murilo999-666/foguetes-garrafa-pet/foguetes/bit03/otimizacao/plots/run_1/surface_ballast_fill_fin_thickness.png

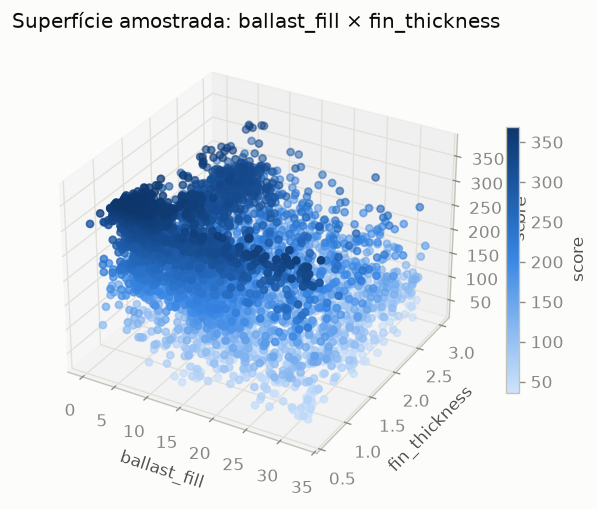
foguetes/bit03/otimizacao/plots/run_1/surface_ballast_fill_fin_thickness.png
