murilo999-666/foguetes-garrafa-pet/laboratorios/construivel/simulacoes/plots/run_1/heatmap_body_length_vinegar_fill.png

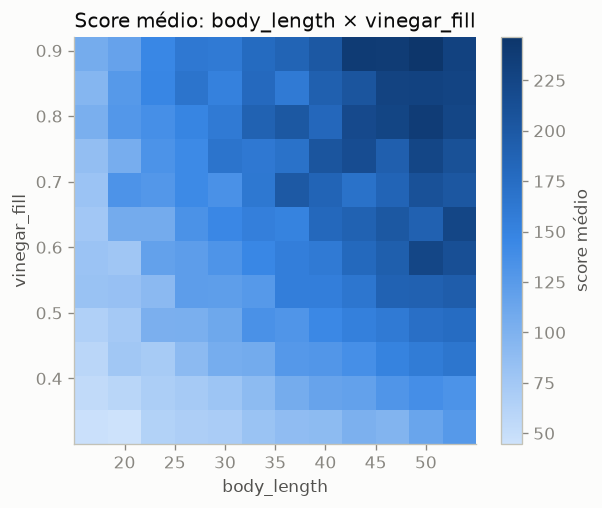
laboratorios/construivel/simulacoes/plots/run_1/heatmap_body_length_vinegar_fill.png
