murilo999-666/foguetes-garrafa-pet/foguetes/bit08/LEIA-ME.md

# bit08 — aletas a 45 graus (6 aletas)

**Projeto vigente: `bit08_MODELO_FINAL.ork`**

## Conteúdo

- `bit08_MODELO_FINAL.ork` — o projeto
- `MOLDE_ALETA_bit08.pdf` — molde de corte da aleta, imprimir em escala 1:1
- `GABARITO_6_ALETAS.pdf` — gabarito de alinhamento das 6 aletas no corpo
- `aletas.svg` — o desenho vetorial da aleta
- `coifa_INTEIRA_parede1.2mm.stl` — coifa em peça única
- `coifa_PARTIDA_1_base.stl` / `coifa_PARTIDA_2_ponta.stl` — a mesma coifa
  dividida em duas, para quem tem mesa de impressão pequena

Antes de imprimir o molde, confira que a impressora não está reescalando a
página (imprimir em "tamanho real", não em "ajustar à página"), senão a aleta
sai com a corda errada e o `.ork` deixa de valer.
