murilo999-666/foguetes-garrafa-pet/foguetes/bit09/LEIA-ME.md

# bit09 — otimizada (3 aletas)

**Projeto vigente: `bit09_MODELO_FINAL.ork`**

## Conteúdo

- `bit09_MODELO_FINAL.ork` — o projeto
- `MOLDE_ALETA_bit09.pdf` — molde de corte da aleta, imprimir em escala 1:1
- `GABARITO_3_ALETAS.pdf` — gabarito de alinhamento das 3 aletas no corpo
- `coifa_INTEIRA_parede1.2mm.stl` — coifa em peça única
- `coifa_PARTIDA_1_base.stl` / `coifa_PARTIDA_2_ponta.stl` — a mesma coifa
  dividida em duas, para mesa de impressão pequena
- `submodelo_coifa_antiga/` — três `.ork` do mesmo foguete com a coifa antiga
  (mínimo, central e máximo). Servem para comparar o efeito da coifa nova;
  não são o projeto vigente. Ver o `LEIA-ME.txt` de dentro.

Antes de imprimir o molde, confira que a impressora não está reescalando a
página (imprimir em "tamanho real", não em "ajustar à página").
