murilo999-666/foguetes-garrafa-pet/foguetes/bit04-2L/LEIA-ME.md

# bit04 — foguete otimizado (garrafa PET 2L)

**Projeto vigente: `bit04_MODELO_FINAL.ork`**

Materiais reais: ogiva impressa em PLA (parede 1,12 mm), aletas de poliestireno
1,0 mm, lastro de 426 g de Durepoxi na ponta da ogiva. Lançamento a 52°.

| Motor | Alcance (média de 20 ventos) | Estabilidade pós-queima |
|---|---|---|
| VinagreReal-1_55L (170 psi, validado) | 369,2 m | 1,01 cal |
| VinagreReal-1_8L (196 psi) | 388,1 m | 1,02 cal |

ATENÇÃO na impressão: a parede da ogiva de 1,12 mm precisa de pelo menos 3
perímetros. Se sair mais fina, o foguete perde lastro e fica instável.
Confirme os 426 g de Durepoxi na balança.

## Outros arquivos
- `bit04.ork`, `bit04_otimizado.ork` — versões anteriores deste foguete
- `foguete_real/` — o estudo digital completo da garrafa 2L (calibração dos
  motores, modelo humano, testes com lastro metálico, bancos de simulação)
- `motores/` — família .eng calibrada
- `backups/` — cópias antigas
