murilo999-666/foguetes-garrafa-pet/foguetes/bit05-2L/LEIA-ME.md

# bit05 — foguete projetado por conhecimento humano (garrafa PET 2L)

**Projeto vigente: `bit05_MODELO_FINAL.ork`**

Projetado 100% por pesquisa e física (OBAFOG, Apogee, Nakka, CFD subsônico),
SEM otimizador — para comparar com o bit04, que saiu de 300 mil simulações.
As fontes e o raciocínio estão em `MODELO_HUMANO_pesquisa.md`.

Materiais reais: ogiva ogival de 22 cm impressa em PLA (parede 1,2 mm), 3 aletas
enflechadas de poliestireno 1,0 mm, 115 g de Durepoxi. Lançamento a 46°.

Alcance previsto: **276 m** com o motor VinagreReal-1_55L (170 psi) —
praticamente igual aos 275 m que o bit03 fez de verdade no campo.

Filosofia: leve, aletas grandes, só o lastro necessário. O bit04 (otimizado) faz
o oposto — pesado, aletas pequenas — e chega a 369 m.
