murilo999-666/foguetes-garrafa-pet/foguetes/bit06-1.8L/_MODELO_ANTIGO_falhou/LEIA-ME.md

# bit06 — garrafa PET retornável REDUZIDA (~1,8 L, Ø9,585 cm)

**Projeto vigente: `bit06_MODELO_FINAL.ork`** (= o campeão com pressão validada
de 170 psi; cópia de `foguete_bit06_OTIMIZADO_SEGURO_170psi.ork`)

Garrafa reduzida de 2L para ~1,8 L: Ø9,585 cm, 33 cm, ~104 g (mesmo peso de uma
retornável comum). Volume menor = mais pressão para a mesma carga de vinagre, e
raio menor = aguenta mais pressão.

| Versão | Motor | Alcance (20 ventos) | Estabilidade |
|---|---|---|---|
| `bit06_MODELO_FINAL.ork` (recomendado) | 1,35 L / **170 psi** | **363,3 m** | 1,03 cal |
| `foguete_bit06_OTIMIZADO.ork` | 1,5 L / 189 psi | 376,2 m | 1,05 cal |
| `foguete_bit06_MODELO_HUMANO.ork` | 1,35 L / 170 psi | 279 m | 1,03 cal |

`garrafa_bit06_base.ork` = o modelo fiel da garrafa vazia (base para novos projetos).
Motores em `motores/` (VinagreBit06-*.eng, 0,5 a 1,5 L de vinagre).
