murilo999-666/foguetes-garrafa-pet/foguetes/bit06-1.8L/_MODELO_ANTIGO_falhou/motores/info_motores.txt

Motores da garrafa reduzida bit05 (~1,8 L internos).
Quimica calibrada em 170 psi/1,55 L (2L); fator de voo k=2.172 (275 m reais).
Volume menor -> mesma carga gera mais pressao que na 2L.
Raio menor (4,79 cm) -> aguenta mais pressao para a mesma parede.
