murilo999-666/foguetes-garrafa-pet/foguetes/bit08/GABARITO_6_ALETAS.pdf

## Gabarito de alinhamento - 6 aletas

Para o bit08. Voce so tem gabarito de 3 - este e o de 6.
Garrafa PET 2L retornavel: diametro 104.0 mm, circunferencia 326.7 mm.

COMO USAR
1. Confira a regua: a barra tem de medir 100 mm de verdade.
2. Recorte a cinta pela linha externa, incluindo a aba de emenda.
3. Enrole na garrafa com a borda de baixo encostada num apoio plano,
para a cinta ficar perpendicular ao eixo.
4. Faca a ponta ESQUERDA coincidir com a linha 'EMENDA AQUI' da direita.
5. Marque a garrafa em cada traco. Sao 6 marcas a 60.0 graus.
6. Alinhe o BORDO DE ATAQUE da raiz de cada aleta na marca.

esta barra tem de medir 100 mm

ALETA 1 | ALETA 2 | ALETA 3 | ALETA 4

tira 1 - de 0.0 a 190.0 mm da circunferencia

ALETA 5 | ALETA 6

EMENDA AQUI

tira 2 - de 190.0 a 326.7 mm da circunferencia
