murilo999-666/foguetes-garrafa-pet/foguetes/bit08/MOLDE_ALETA_bit08.pdf

## bit08 - trapezio da foto (BA 45 graus, BF perpendicular)

Foguete bit08 - OBAFOG modelo 4 - garrafa PET 2L retornavel
6 aletas iguais. Imprimir em ESCALA REAL (100%), sem 'ajustar a pagina'.
A linha tracejada horizontal e a linha do corpo reto da garrafa; a parte
abaixo dela e o lobo que acompanha a curva do ombro.
- Corda da raiz (sobre a linha do corpo reto): 90.0 mm
- Corda da ponta: 34.3 mm Envergadura: 55.7 mm Enflechamento: 55.7 mm
- Bordo de ataque: 45.0 graus
- Area de cada aleta (com o lobo do ombro): 39.6 cm2
- Linha de cola (segue o ombro): 99 mm
- Quantidade a cortar: 6 aletas iguais
- Construcao: depron 2mm + PET de garrafa 0,3mm 2 lados
- As pontas ocupam 215 mm de diametro - confira a base antes de cortar.
- Lastro: 368 g de chumbinho de pesca socado na PONTA da coifa.
- Posicionar: o bordo de ataque da raiz fica a 176 mm do topo do
- cilindro da garrafa (a marca tracejada indica onde o cilindro acaba).
- Margem de estabilidade: 2.00 cal no fim do voo, minima de 0.00 cal.
- As peles saem do cilindro de uma garrafa 2L cortada e achatada.
- Lixe o PET antes de colar - epoxi nao pega em PET liso.
- Cole as duas faces no mesmo dia, prensado ate curar.
- OPCIONAL, e o melhor uso do seu rolo: uma tira de carbono de 100 mm ao
- longo da LINHA DE COLA, nas duas faces de cada aleta. A tira de 10 cm
- nao serve de pele inteira, mas serve exatamente para isto - reforcar a
- juncao, que e onde a aleta arranca. Gasta ~900 mm do rolo nas 3 aletas.

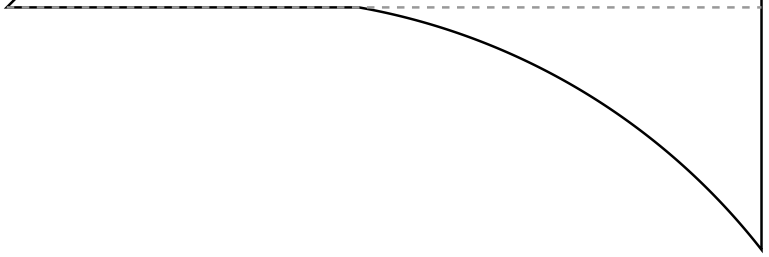
[picture p5: figure]

vista reduzida - o molde 1:1 vem nas 1 folhas seguintes (1 col x 1 lin)

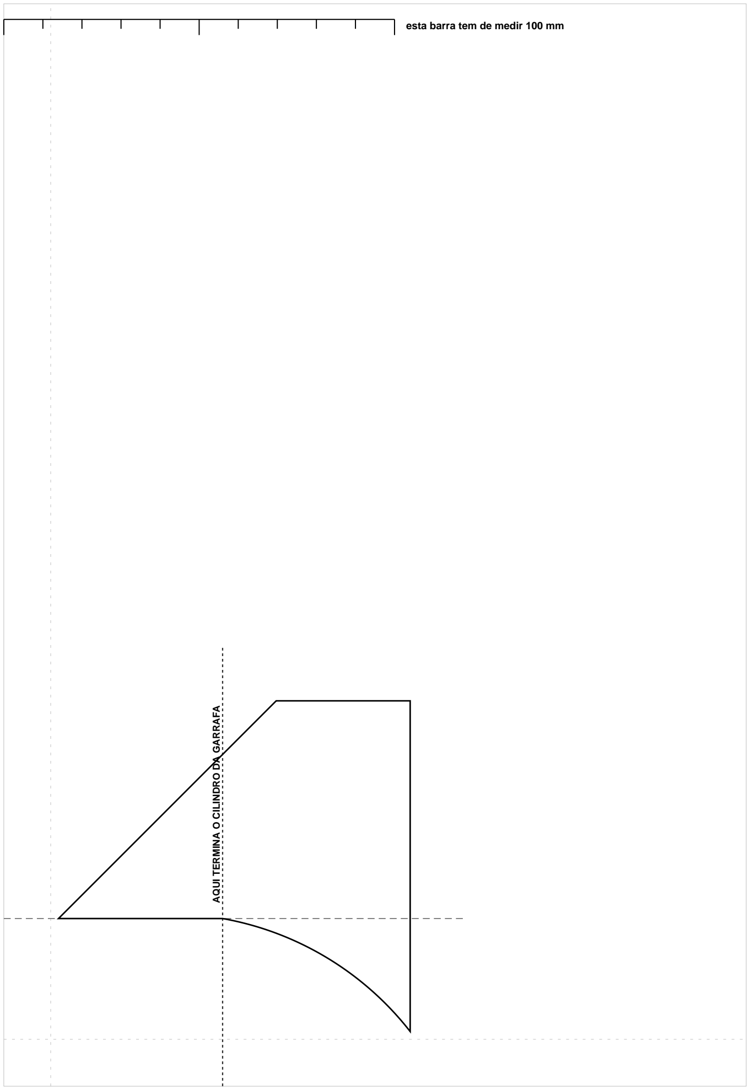
[picture p6: figure]
esta barra tem de medir 100 mm; AQUI TERMINA O CILINDRO DA GARRAFA

bit08 - trapezio da foto (BA 45 graus, BF perpendicular) | folha coluna 1 de 1, linha 1 de 1 | ESCALA 1:1
