murilo999-666/foguetes-garrafa-pet/foguetes/bit09/MOLDE_ALETA_bit09.pdf

## bit09 - aleta otimizada (sem restricao de angulo)

Foguete bit09 - OBAFOG modelo 4 - garrafa PET 2L retornavel
3 aletas iguais. Imprimir em ESCALA REAL (100%), sem 'ajustar a pagina'.
A linha tracejada horizontal e a linha do corpo reto da garrafa; a parte
abaixo dela e o lobo que acompanha a curva do ombro.
- Corda da raiz (sobre a linha do corpo reto): 85.0 mm
- Corda da ponta: 50.0 mm Envergadura: 140.0 mm Enflechamento: 95.0 mm
- Bordo de ataque: 34.2 graus
- Area de cada aleta (com o lobo do ombro): 108.2 cm2
- Linha de cola (segue o ombro): 94 mm
- Quantidade a cortar: 3 aletas iguais
- Construcao: 2x depron 2mm + PET de garrafa 0,3mm 2 lados
- As pontas ocupam 384 mm de diametro - confira a base antes de cortar.
- Lastro: 50 g de chumbinho de pesca socado na PONTA da coifa.
- Posicionar: o bordo de ataque da raiz fica a 181 mm do topo do
- cilindro da garrafa (a marca tracejada indica onde o cilindro acaba).
- Margem de estabilidade: 1.44 cal no fim do voo, minima de 0.01 cal.
- As pontas passam 53 mm alem da boca da garrafa - so longe do eixo,
- entao nao encostam no cano da base, mas confira mesmo assim.
- Cole as duas placas de depron 2 mm entre si primeiro (epoxi, prensadas).
- As peles saem do cilindro de uma garrafa 2L cortada e achatada.
- LIXE o PET antes de colar - epoxi nao pega em PET liso e brilhante.
- Cole as duas peles no MESMO dia: se so uma curar, a peca empena.
- Prense entre duas chapas planas ate curar.
- Afile o bordo de fuga nos ultimos 15-20 mm: o bordo rombudo responde
- por dois tercos da penalidade de arrasto.
- ALTERNATIVA sem cortar PET: depron 2 mm com peles de
- poliestireno 1 mm nos dois lados. Mesma margem, mas o lastro
- passa de 50 g para 90 g e o foguete fica 79 g mais pesado.
- OPCIONAL, e o melhor uso do seu rolo: uma tira de carbono de 100 mm ao
- longo da LINHA DE COLA, nas duas faces de cada aleta. A tira de 10 cm
- nao serve de pele inteira, mas serve exatamente para isto - reforcar a
- juncao, que e onde a aleta arranca. Gasta ~900 mm do rolo nas 3 aletas.

vista reduzida - o molde 1:1 vem nas 1 folhas seguintes (1 col x 1 lin)

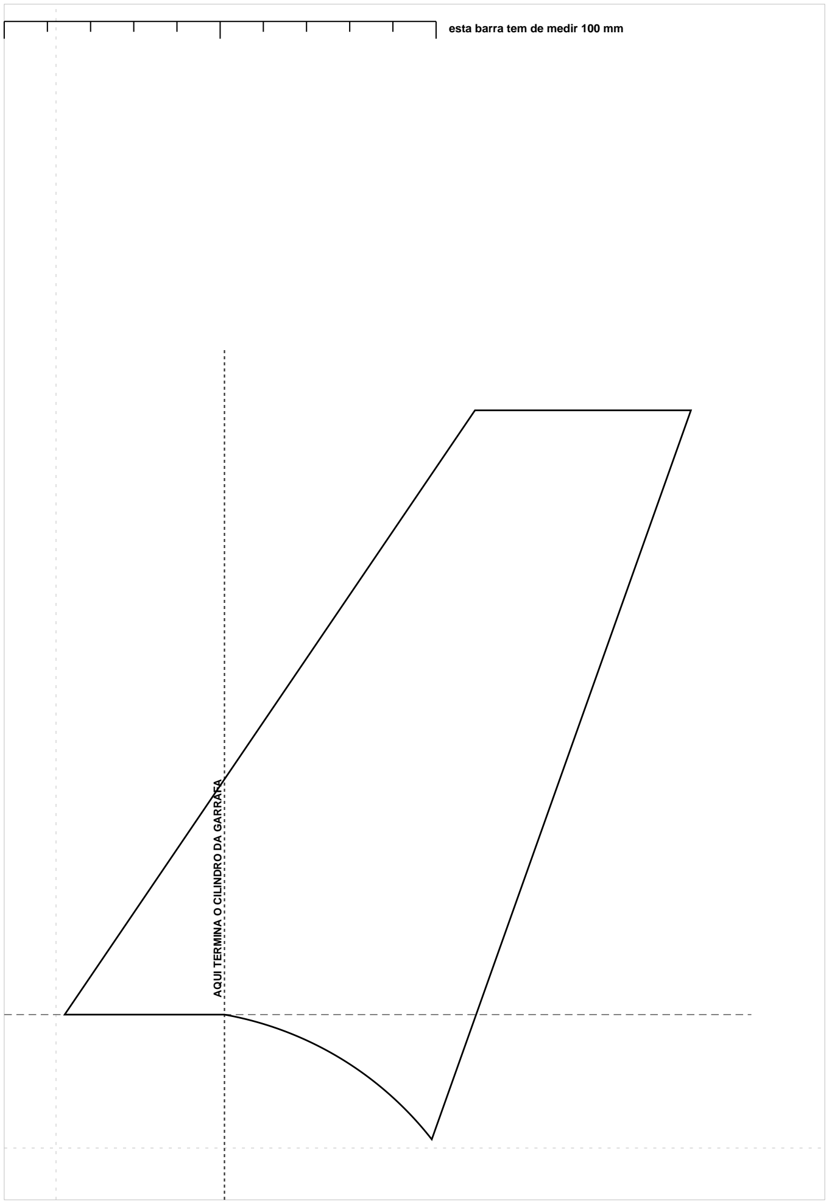
[picture p7: figure]
esta barra tem de medir 100 mm; AQUI TERMINA O CILINDRO DA GARRAFA

bit09 - aleta otimizada (sem restricao de angulo) | folha coluna 1 de 1, linha 1 de 1 | ESCALA 1:1
