murilo999-666/foguetes-garrafa-pet/foguetes/bit06-1.8L/impressao_PET/bit06pet_aleta_molde.pdf

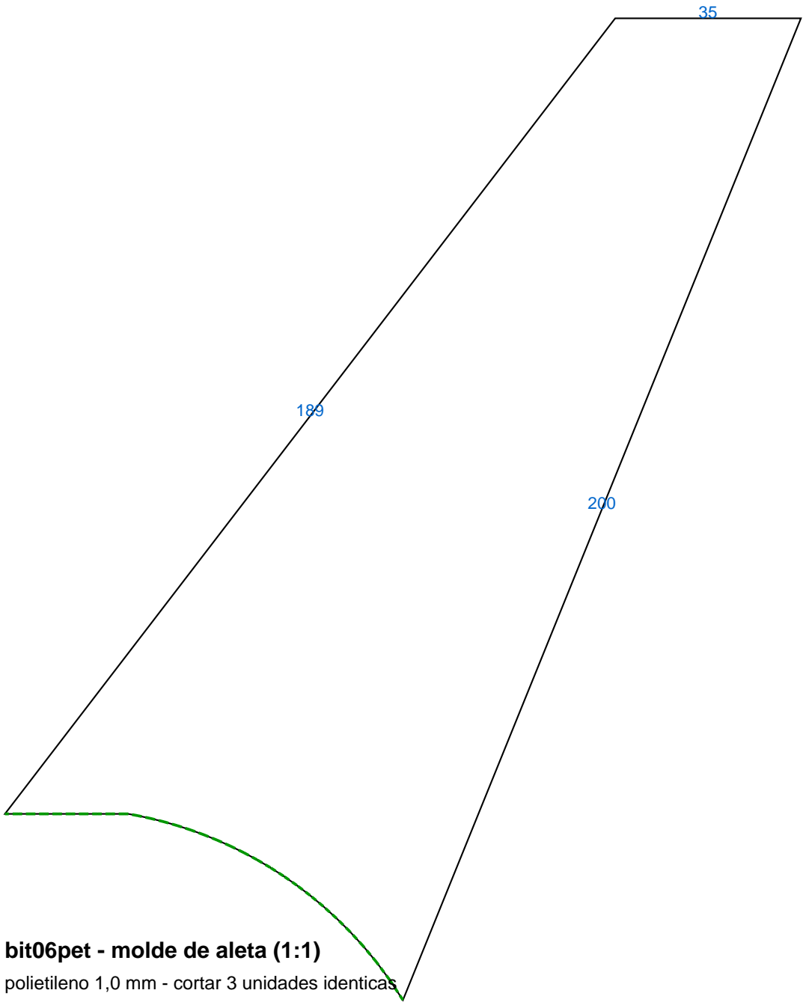
[picture p8: figure]
bit06pet - molde de aleta (1:1)

polietileno 1,0 mm - cortar 3 unidades identicas

100 mm - imprima a 100% (sem "ajustar a pagina")
