murilo999-666/foguetes-garrafa-pet/foguetes/bit05-2L/impressão/bit05_aleta_molde.pdf

bit05 aleta — 140.0 x 141.6 mm — escala 1:1, imprima SEM ajuste de página
