murilo999-666/foguetes-garrafa-pet/foguetes/bit07-2L/impressão/bit07_aleta_molde.pdf

bit07 ? bit07 aleta ? 140.4 x 175.2 mm ? escala 1:1, imprima SEM ajuste de pÆgina

100 mm - confira com a regua
