murilo999-666/foguetes-garrafa-pet/foguetes/bit07-2L/impressão/bit07_B/bit07_B_aleta_molde.pdf

201

11

197

85

### bit07_B - molde de aleta (1:1)

Polietileno 1,0 mm - cortar 4 unidades identicas

100 mm - imprima a 100% (sem "ajustar a pagina")
