murilo999-666/foguetes-garrafa-pet/foguetes/bit07-2L/impressão/margem_extra/bit07E_aleta_molde.pdf

bit07 margem extra ? bit07E aleta ? 170.9 x 172.3 mm ? escala 1:1, imprima SEM ajuste de pÆgina

100 mm - confira com a regua
