murilo999-666/foguetes-garrafa-pet/docs/playlist-referencias.md

# Playlist de referência (vídeos não versionados)

Os vídeos de pesquisa somam ~5,6 GB e são conteúdo de terceiros (YouTube),
por isso ficam fora do repositório. A lista abaixo preserva a referência.
Os arquivos continuam em `D:\OBAFOG\playlist` no computador do Murilo.

| # | vídeo | MB |
|---|---|---|
| 001 | 001 - Como fazer um foguete de garrafa pet que voa 300 metros - MOBFOG | 102 |
| 002 | 002 - O novo o recorde da mobfog nivel 4, equipe red bears, teve um alcance de 488,5 metros.🚀🚀🚀 | 113 |
| 003 | 003 - Lançamento de foguete MOBFOG 2015 - nível 4 | 18 |
| 004 | 004 - Como sair dos 100 metros e passar dos 300!!! Foguete OBAFOG | 160 |
| 005 | 005 - COMO FAZER UM FOGUETE DE GARRAFA PET, DE VINAGRE E BICARBONATO (160mts) - MOBFOG | 103 |
| 006 | 006 - Análise Aerodinâmica de Foguete #1 utilizando ANSYS 2020 - Abordagem 2D Steady-State | 317 |
| 008 | 008 - COMO FAZER UM GATILHO PARA GARRAFAS RETORNÁVEIS - PARTE 1 - #7.ab | 0 |
| 008 | 008 - COMO FAZER UM GATILHO PARA GARRAFAS RETORNÁVEIS - PARTE 1 - #7 | 184 |
| 009 | 009 - Respondendo Comentários -- PARTE 2 -- #21 (¨Aletas, ogiva, Centro de Massa, Centro de Pressão¨.. ) | 675 |
| 010 | 010 - Foguete de Fibra de vidro | 10 |
| 011 | 011 - COMO ENCONTRAR O CENTRO DE PRESSÃO E DE GARVIDADE DO FOGUETE DE GARRAFA PET？ E CALCULAR O CALIBRE？ | 254 |
| 012 | 012 - Como melhorar seu foguete na OBAFOG (Nível 3 e 4).ab | 0 |
| 012 | 012 - Como melhorar seu foguete na OBAFOG (Nível 3 e 4) | 2.652 |
| 013 | 013 - E agora？ Revestir ou não o meu foguete？ #29.aa | 0 |
| 013 | 013 - E agora？ Revestir ou não o meu foguete？ #29.ab | 0 |
| 013 | 013 - E agora？ Revestir ou não o meu foguete？ #29 | 75 |
| 015 | 015 - CENTRO DE PRESSÃO E CENTRO DE GRAVIDADE - Antares Foguetemodelismo ｜ UNICAMP | 63 |
| 016 | 016 - Foguete NOVO e TURBINADO para MOBFOG Nível 3 e 4. IMPERDÍVEL | 188 |
| 017 | 017 - SUPER BASE DE LANÇAMENTO PARA MOBFOG 2025 - Segurança e Desempenho | 257 |
| 018 | 018 - Como realizar o lançamento do seu foguete na MOBFOG | 133 |
| 019 | 019 - Reduzindo garrafa de 2 litros para construção de foguetes.ab | 0 |
| 019 | 019 - Reduzindo garrafa de 2 litros para construção de foguetes | 113 |
| 020 | 020 - Balão com vinagre dentro do foguete! - Como Faço？？.ab | 0 |
| 020 | 020 - Balão com vinagre dentro do foguete! - Como Faço？？ | 231 |
| baixados | baixados | 0 |
