murilo999-666/foguetes-garrafa-pet/foguetes/bit06-1.8L/FICHA_DE_CAMPO.pdf

# bit06 PET — ficha de campo

Preencha NO LOCAL, com o foguete na mão. É este papel que calibra o próximo projeto.

## 1. Antes de montar

Data | Hora
Local | Vento (fraco/médio/forte)
Direção do vento | Temperatura

## 2. O foguete, medido de verdade

Massa seca na balança (g) | Lastro pesado (g)
Nº de aletas / material | Espessura da aleta (mm)
Comprimento total (cm) | Nº do voo desta garrafa

## 3. O motor — o campo mais importante da ficha

Vinagre (L) ______________ Bicarbonato (g) ______________ Ângulo (°) ______________

PRESSÃO NO MANÔMETRO (psi): ______________________ quando estabilizou? ____________
Vazou? por onde? _______________________________________________________________

Sem a pressão medida, o voo não ensina nada. Toda a física do projeto está ancorada em dois números reais seus: 170 psi na bancada e os 275 m do bit03. Cada pressão anotada melhora o modelo.

## 4. O que aconteceu

Alcance medido (m) | Como mediu (passos/trena)
Tempo de voo (s) | Apogeu estimado (m)
Saiu reto do tubo-guia? | Girou / cambaleou?
Bateu em quê, se bateu | Aleta entortou/soltou?

## 5. Escreva o que os números não pegam

Ex.: a garrafa demorou a soltar? o gatilho travou? a base afundou? o vento virou na hora? choveu antes? a cola ainda estava mole? — isso costuma explicar mais que a simulação.

## 6. Números que o projeto esperava (para comparar na hora)

Se o manômetro der… | …espere um alcance de
~120 psi (reação ruim) | ~256 m
~137 psi (o que sua bancada deu no bit04/05) | ~272 m
~154 psi (bom dia) | ~289 m
~171 psi (teto físico de 1,35 L) | ~298 m

Carga de projeto: 1,35 L de vinagre + ~176 g de bicarbonato, a 53°. Acima de 171 psi é impossível com essa carga — se o manômetro passar disso, desconfie do manômetro.
