murilo999-666/foguetes-garrafa-pet/foguetes/bit03/otimizacao/plots/comparacao_runs.png

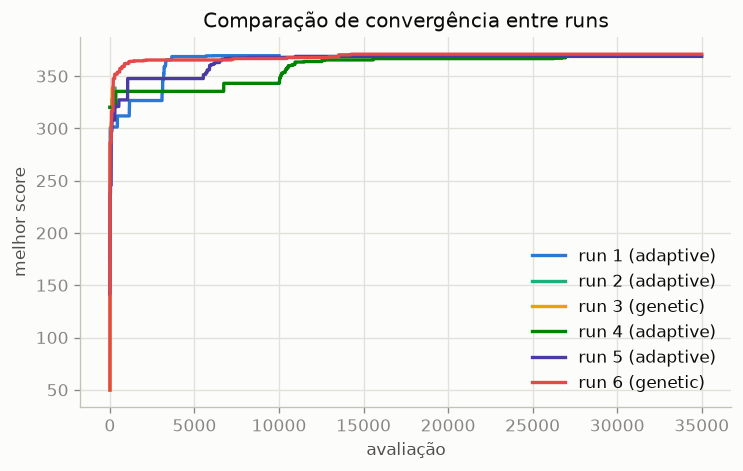
foguetes/bit03/otimizacao/plots/comparacao_runs.png
