murilo999-666/foguetes-garrafa-pet/foguetes/bit03/otimizacao/plots/run_2/convergence.png

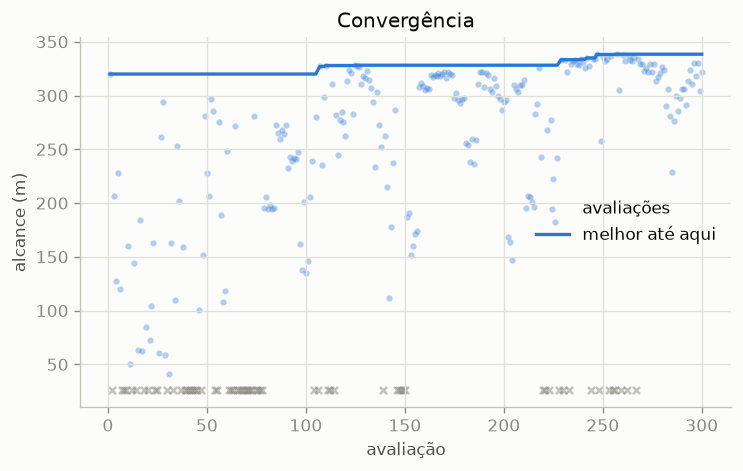
foguetes/bit03/otimizacao/plots/run_2/convergence.png
