murilo999-666/foguetes-garrafa-pet/foguetes/bit03/otimizacao/plots/run_2/heatmap_nose_length_fin_thickness.png

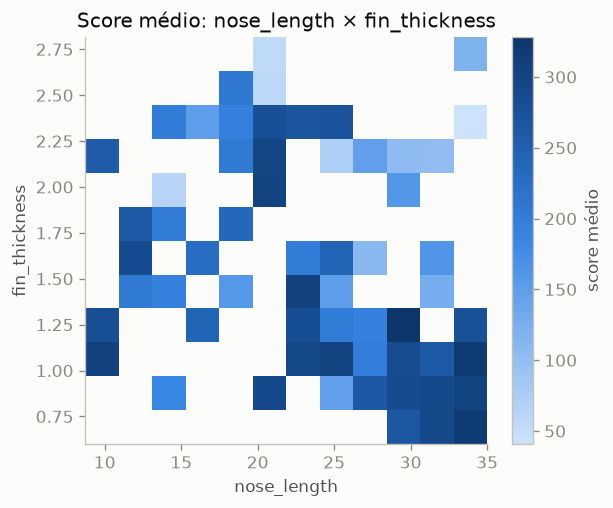
foguetes/bit03/otimizacao/plots/run_2/heatmap_nose_length_fin_thickness.png
