murilo999-666/foguetes-garrafa-pet/foguetes/bit03/otimizacao/plots/run_2/param_effects.png

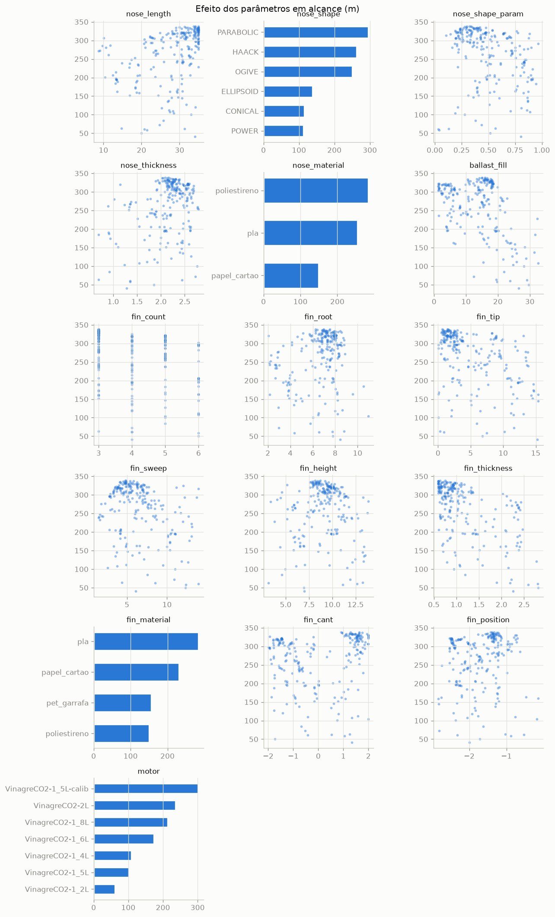
foguetes/bit03/otimizacao/plots/run_2/param_effects.png
