murilo999-666/foguetes-garrafa-pet/foguetes/bit03/otimizacao/plots/run_2/surface_nose_length_fin_thickness.png

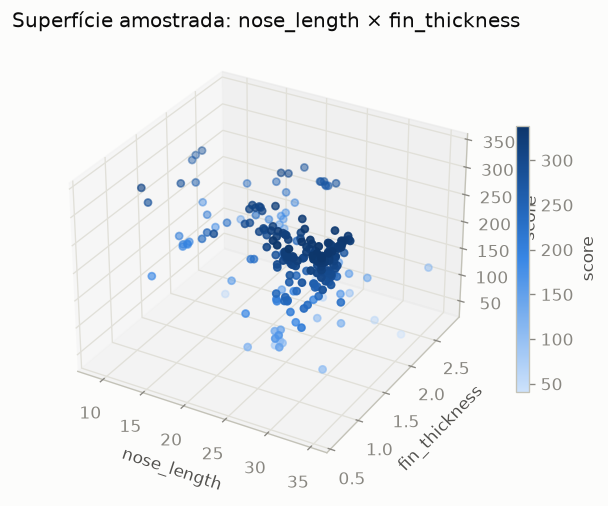
foguetes/bit03/otimizacao/plots/run_2/surface_nose_length_fin_thickness.png
