murilo999-666/foguetes-garrafa-pet/foguetes/bit03/otimizacao/plots/run_3/surface_fin_count_nose_length.png

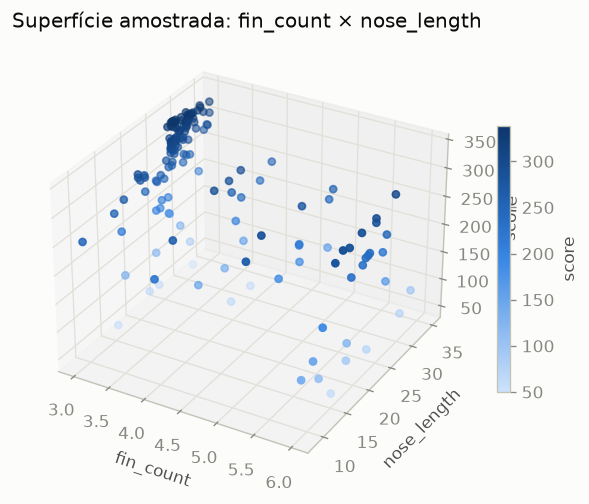
foguetes/bit03/otimizacao/plots/run_3/surface_fin_count_nose_length.png
