murilo999-666/foguetes-garrafa-pet/foguetes/bit03/otimizacao/plots/run_5/convergence.png

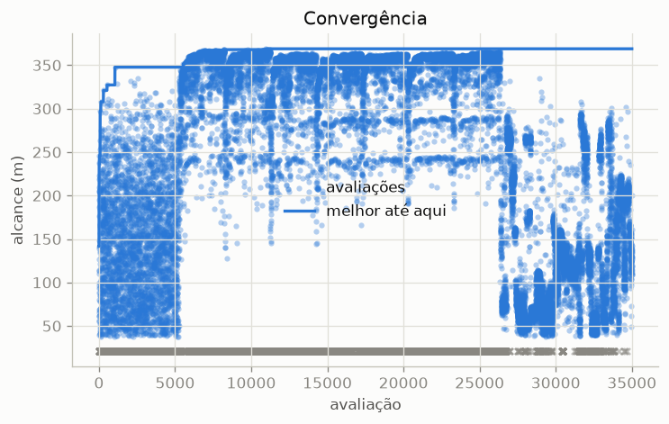
foguetes/bit03/otimizacao/plots/run_5/convergence.png
