murilo999-666/foguetes-garrafa-pet/foguetes/bit03/otimizacao/plots/run_5/histograms.png

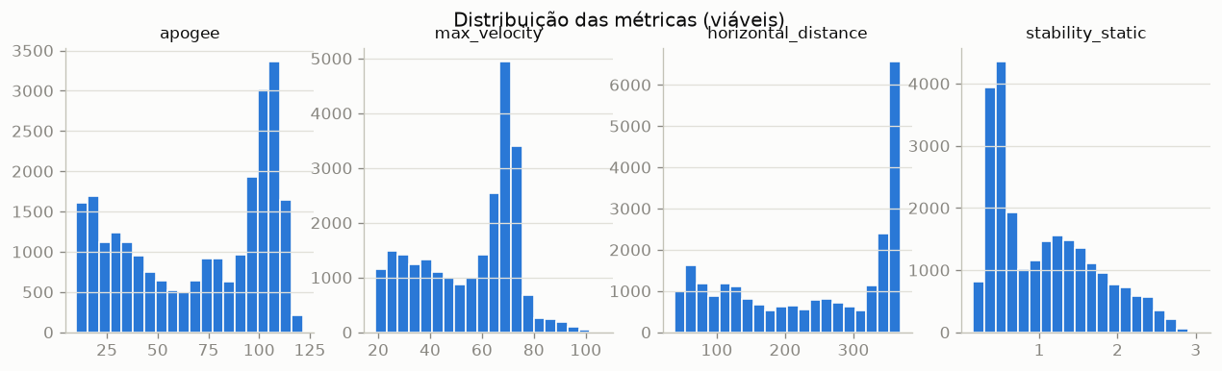
foguetes/bit03/otimizacao/plots/run_5/histograms.png
