murilo999-666/foguetes-garrafa-pet/foguetes/bit03/otimizacao/plots/run_5/surface_fin_height_ballast_fill.png

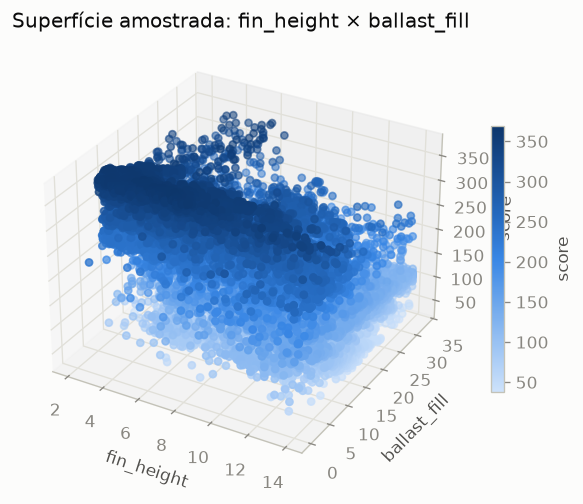
foguetes/bit03/otimizacao/plots/run_5/surface_fin_height_ballast_fill.png
