murilo999-666/foguetes-garrafa-pet/foguetes/bit03/otimizacao/plots/run_6/convergence.png

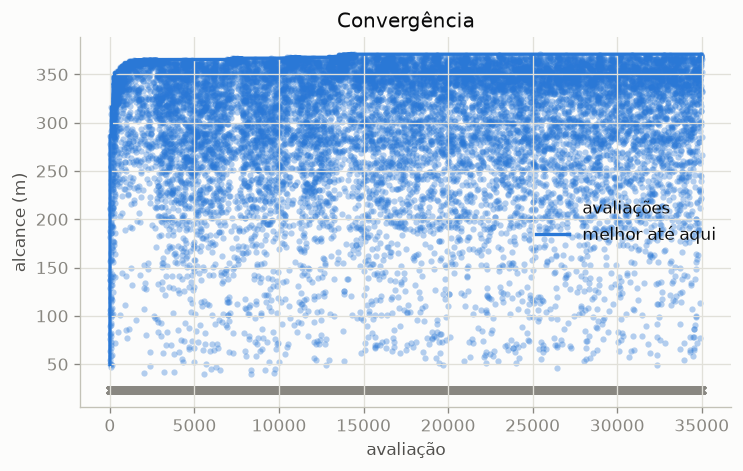
foguetes/bit03/otimizacao/plots/run_6/convergence.png
