murilo999-666/foguetes-garrafa-pet/foguetes/bit03/otimizacao/plots/run_6/heatmap_ballast_fill_fin_height.png

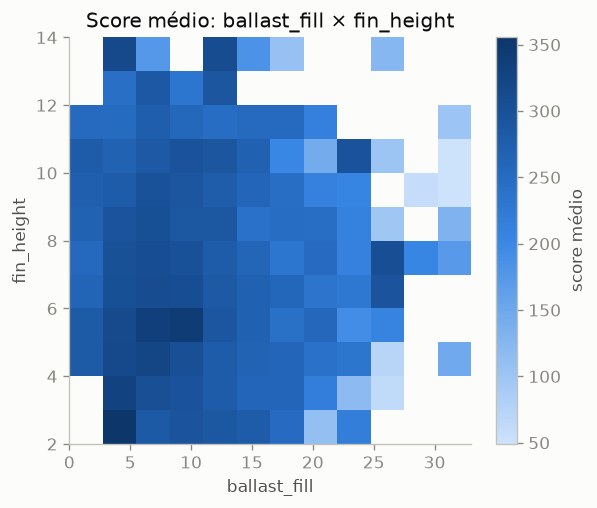
foguetes/bit03/otimizacao/plots/run_6/heatmap_ballast_fill_fin_height.png
