murilo999-666/foguetes-garrafa-pet/foguetes/bit03/otimizacao/plots/run_6/pareto_apogee_distance.png

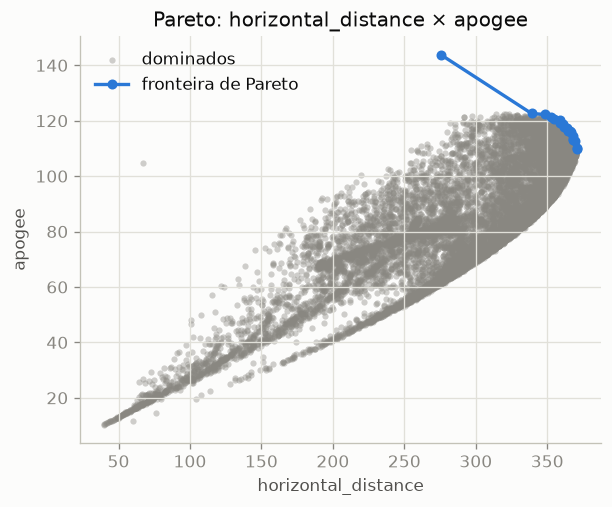
foguetes/bit03/otimizacao/plots/run_6/pareto_apogee_distance.png
