murilo999-666/foguetes-garrafa-pet/foguetes/bit03/otimizacao_pet/plots/run_1/convergence.png

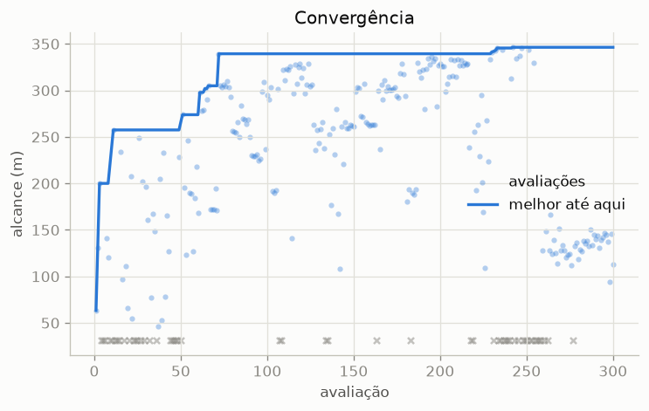
foguetes/bit03/otimizacao_pet/plots/run_1/convergence.png
