murilo999-666/foguetes-garrafa-pet/foguetes/bit03/otimizacao_pet/plots/run_1/param_effects.png

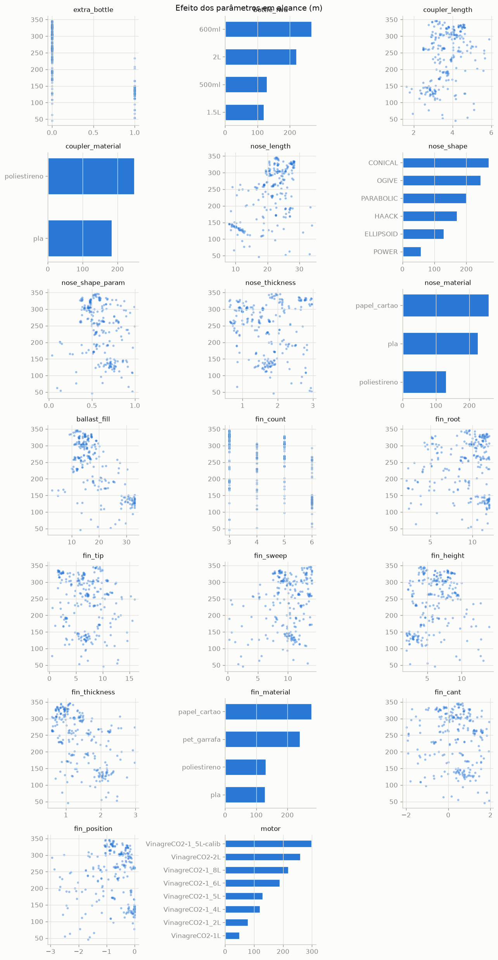
foguetes/bit03/otimizacao_pet/plots/run_1/param_effects.png
