murilo999-666/foguetes-garrafa-pet/foguetes/bit03/otimizacao_pet/plots/run_1/pareto_apogee_distance.png

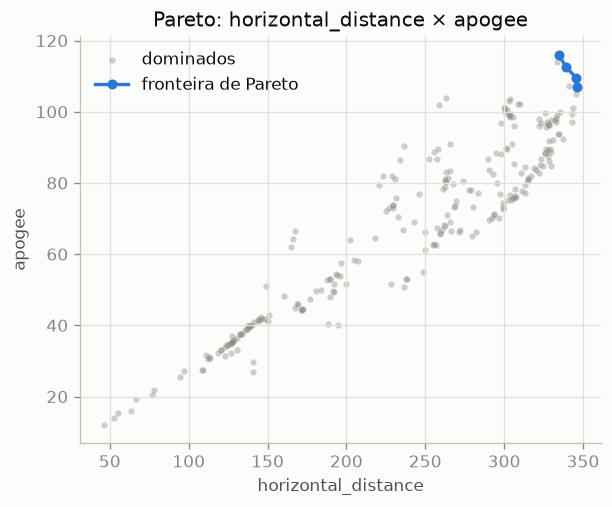
foguetes/bit03/otimizacao_pet/plots/run_1/pareto_apogee_distance.png
