murilo999-666/foguetes-garrafa-pet/foguetes/bit03/otimizacao_pet/plots/run_1/surface_extra_bottle_fin_thickness.png

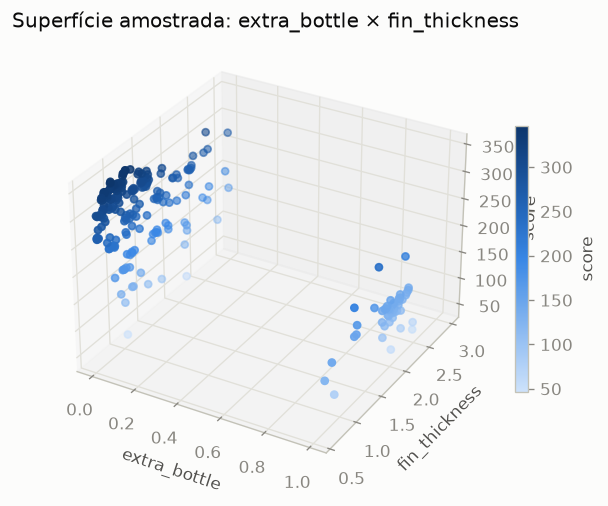
foguetes/bit03/otimizacao_pet/plots/run_1/surface_extra_bottle_fin_thickness.png
