murilo999-666/foguetes-garrafa-pet/foguetes/bit03/otimizacao_pet/plots/run_2/heatmap_fin_height_fin_sweep.png

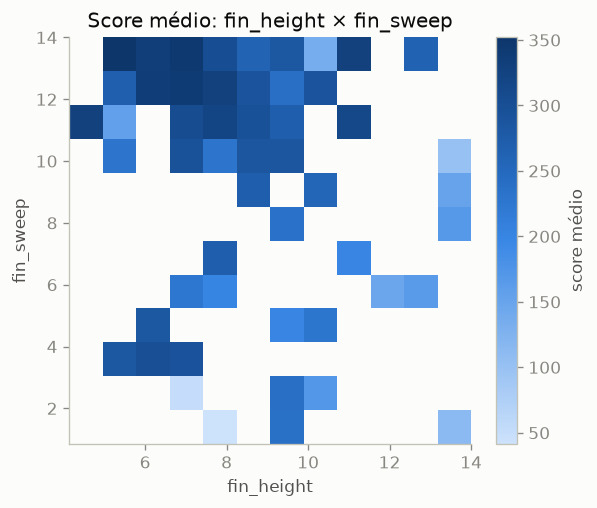
foguetes/bit03/otimizacao_pet/plots/run_2/heatmap_fin_height_fin_sweep.png
