murilo999-666/foguetes-garrafa-pet/foguetes/bit03/otimizacao_pet/plots/run_2/heatmap_fin_sweep_extra_bottle.png

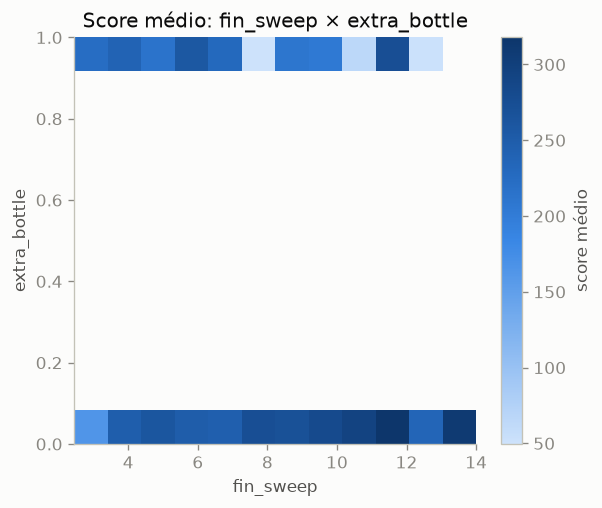
foguetes/bit03/otimizacao_pet/plots/run_2/heatmap_fin_sweep_extra_bottle.png
