murilo999-666/foguetes-garrafa-pet/foguetes/bit03/otimizacao_pet/plots/run_3/surface_fin_thickness_ballast_fill.png

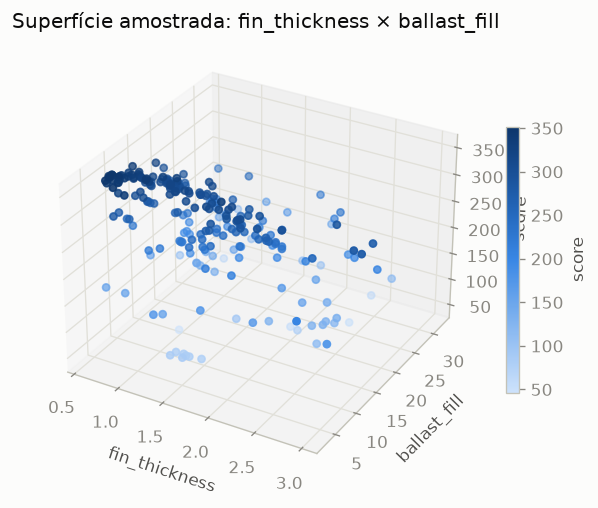
foguetes/bit03/otimizacao_pet/plots/run_3/surface_fin_thickness_ballast_fill.png
