murilo999-666/foguetes-garrafa-pet/foguetes/bit03/otimizacao_pet/plots/run_4/histograms.png

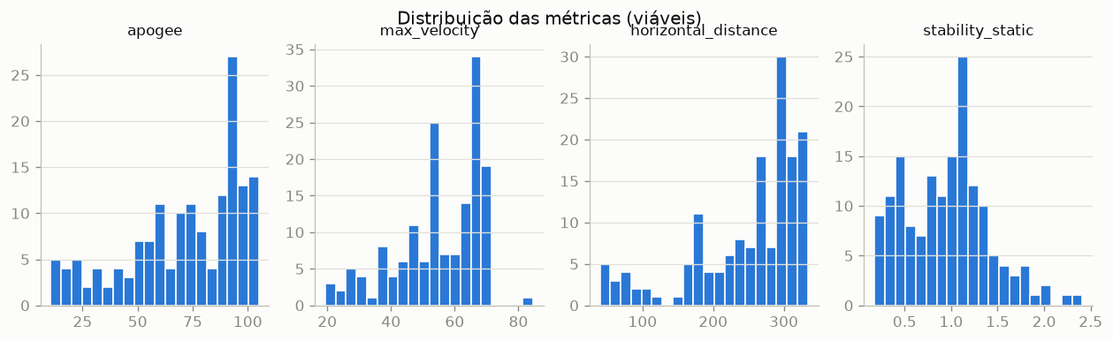
foguetes/bit03/otimizacao_pet/plots/run_4/histograms.png
