murilo999-666/foguetes-garrafa-pet/foguetes/bit03/otimizacao_pet/plots/run_4/surface_fin_sweep_nose_length.png

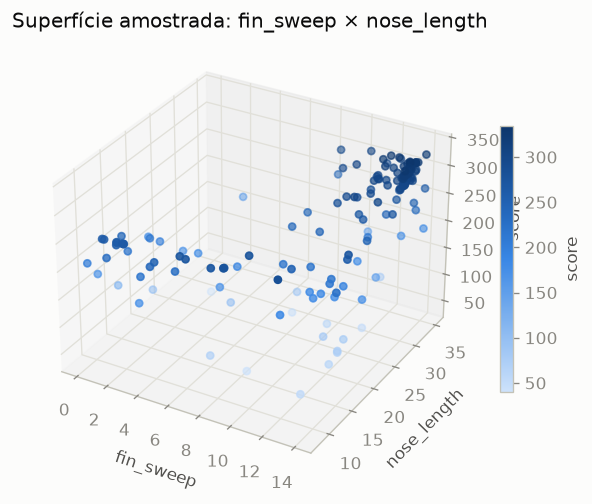
foguetes/bit03/otimizacao_pet/plots/run_4/surface_fin_sweep_nose_length.png
