murilo999-666/foguetes-garrafa-pet/foguetes/bit04-2L/foguete_real/otimizacao/plots/run_1/heatmap_fin_thickness_fin_root.png

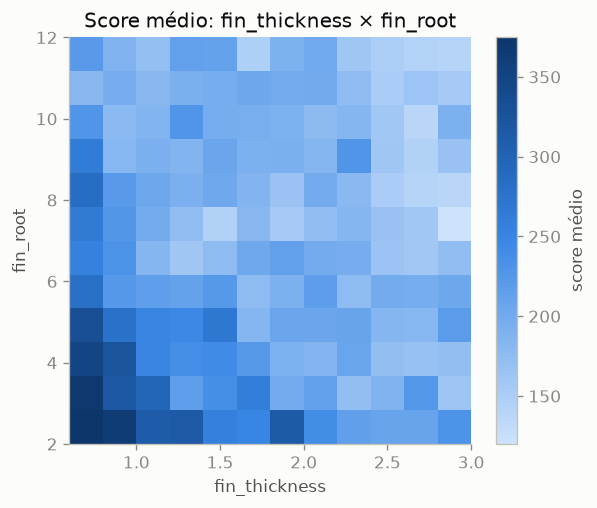
foguetes/bit04-2L/foguete_real/otimizacao/plots/run_1/heatmap_fin_thickness_fin_root.png
