murilo999-666/foguetes-garrafa-pet/foguetes/bit04-2L/foguete_real/otimizacao/plots/run_1/surface_fin_root_nose_length.png

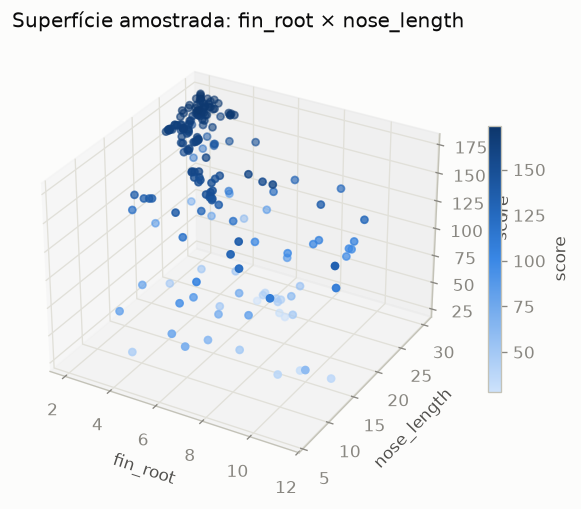
foguetes/bit04-2L/foguete_real/otimizacao/plots/run_1/surface_fin_root_nose_length.png
