murilo999-666/foguetes-garrafa-pet/foguetes/bit04-2L/foguete_real/otimizacao_aletas/plots/run_1/param_effects.png

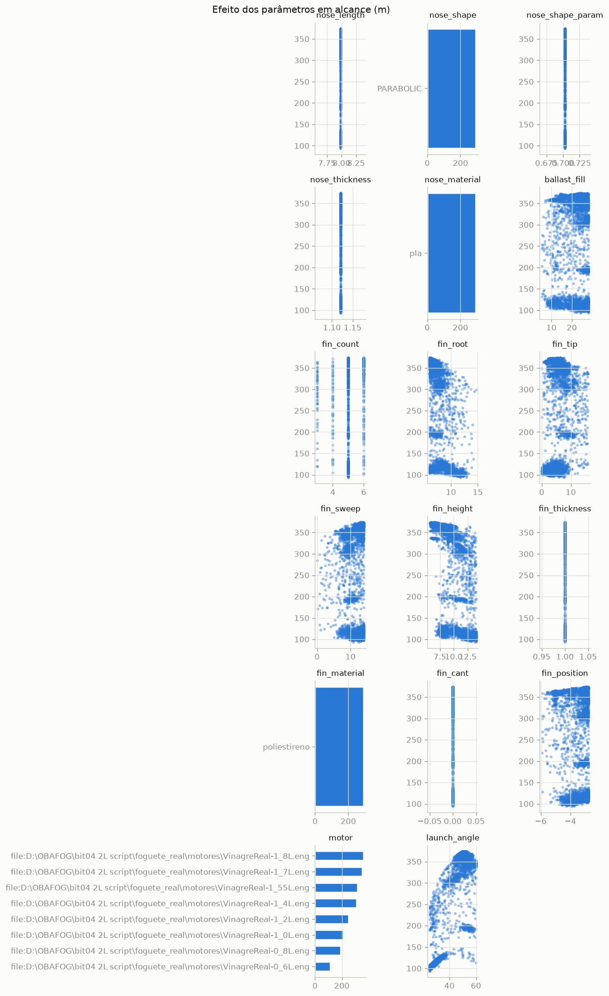
foguetes/bit04-2L/foguete_real/otimizacao_aletas/plots/run_1/param_effects.png
