murilo999-666/foguetes-garrafa-pet/foguetes/bit04-2L/foguete_real/otimizacao_aletas/plots/run_1/pareto_apogee_distance.png

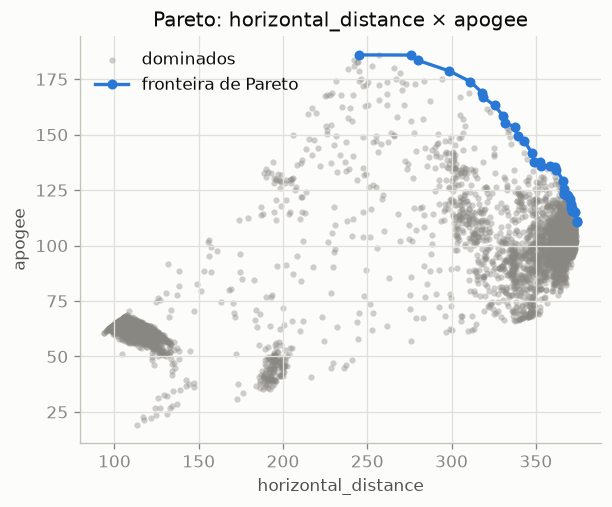
foguetes/bit04-2L/foguete_real/otimizacao_aletas/plots/run_1/pareto_apogee_distance.png
