murilo999-666/foguetes-garrafa-pet/foguetes/bit04-2L/otimizacao/plots/run_1/heatmap_ballast_mass_fin_root.png

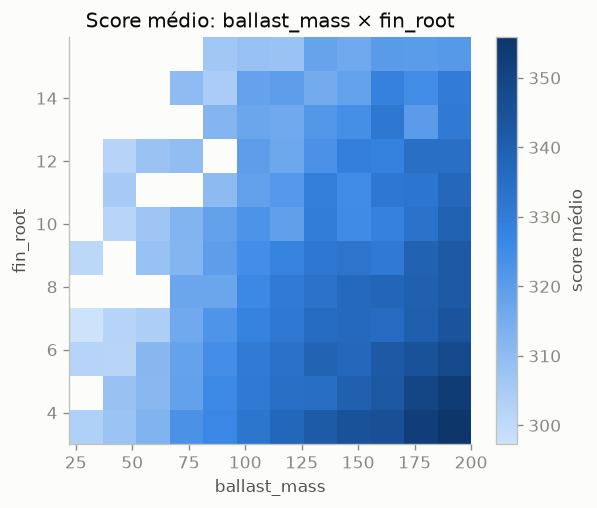
foguetes/bit04-2L/otimizacao/plots/run_1/heatmap_ballast_mass_fin_root.png
