murilo999-666/foguetes-garrafa-pet/foguetes/bit04-2L/otimizacao/plots/run_1/pareto_apogee_distance.png

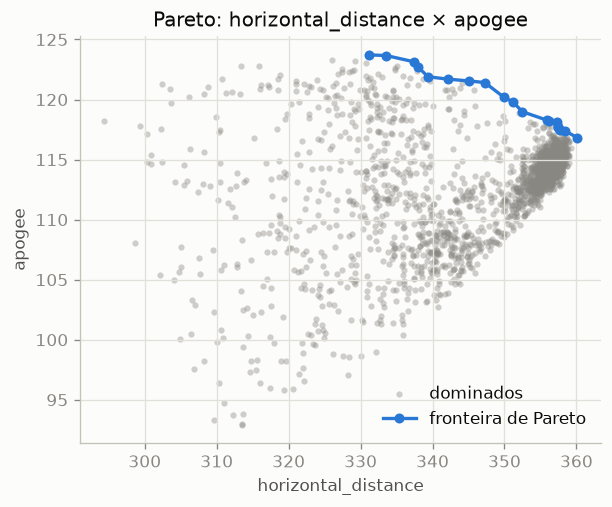
foguetes/bit04-2L/otimizacao/plots/run_1/pareto_apogee_distance.png
