murilo999-666/foguetes-garrafa-pet/foguetes/bit04-2L/otimizacao/plots/run_2/param_effects.png

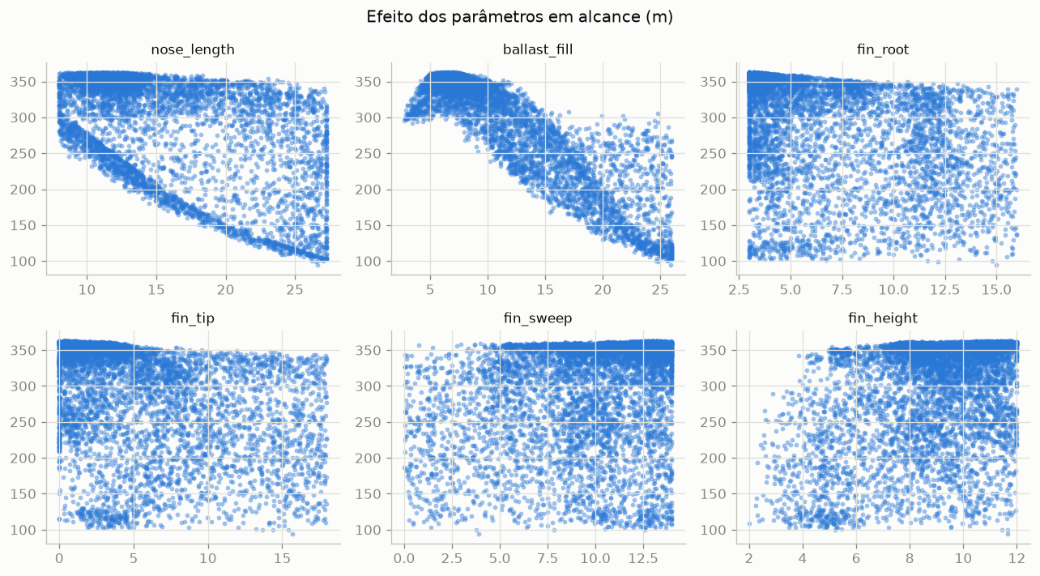
foguetes/bit04-2L/otimizacao/plots/run_2/param_effects.png
