murilo999-666/foguetes-garrafa-pet/foguetes/bit06-1.8L/_MODELO_ANTIGO_falhou/simulacoes/plots/run_2/convergence.png

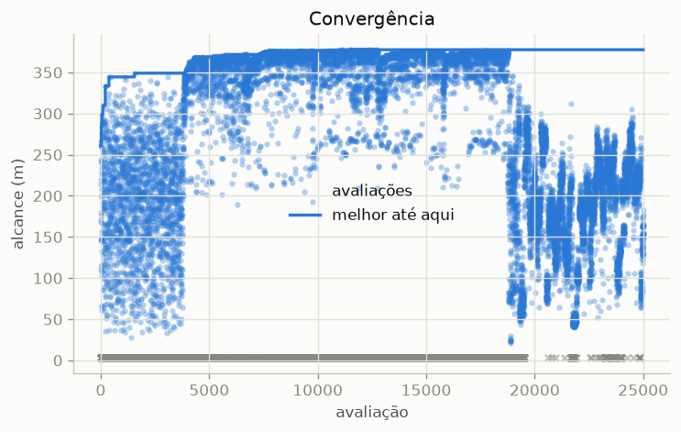
foguetes/bit06-1.8L/_MODELO_ANTIGO_falhou/simulacoes/plots/run_2/convergence.png
