murilo999-666/foguetes-garrafa-pet/foguetes/bit06-1.8L/_MODELO_ANTIGO_falhou/simulacoes/plots/run_3/pareto_apogee_distance.png

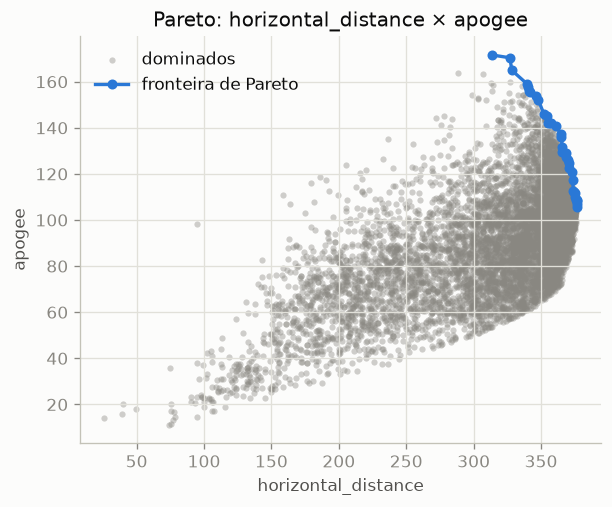
foguetes/bit06-1.8L/_MODELO_ANTIGO_falhou/simulacoes/plots/run_3/pareto_apogee_distance.png
