murilo999-666/foguetes-garrafa-pet/foguetes/bit06-1.8L/_MODELO_ANTIGO_falhou/simulacoes/plots/run_3/surface_fin_height_fin_count.png

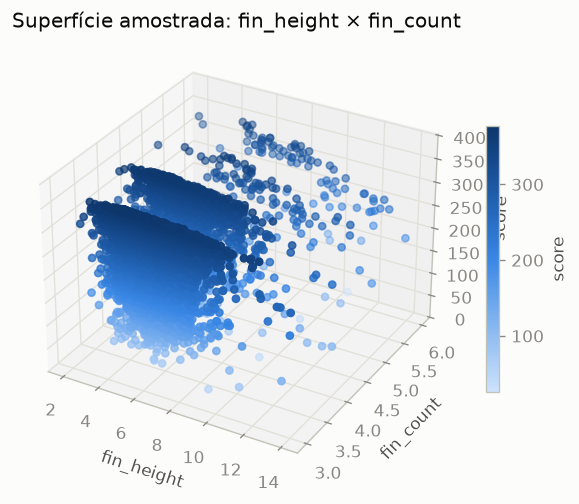
foguetes/bit06-1.8L/_MODELO_ANTIGO_falhou/simulacoes/plots/run_3/surface_fin_height_fin_count.png
