murilo999-666/foguetes-garrafa-pet/laboratorios/construivel/simulacoes/plots/comparacao_estrategias.png

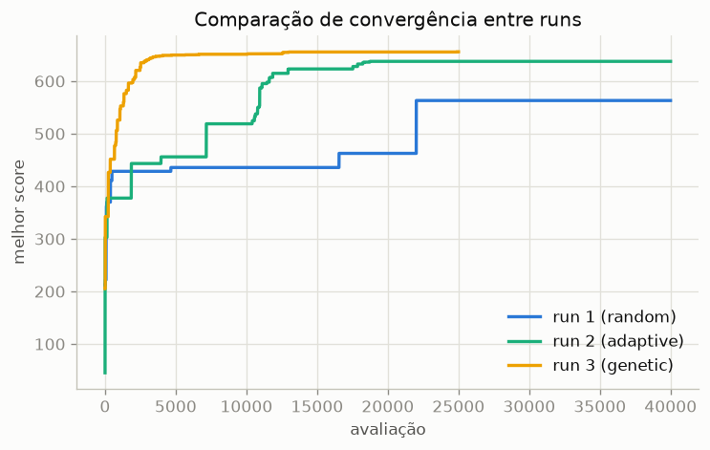
laboratorios/construivel/simulacoes/plots/comparacao_estrategias.png
