murilo999-666/foguetes-garrafa-pet/laboratorios/construivel/simulacoes/plots/run_1/convergence.png

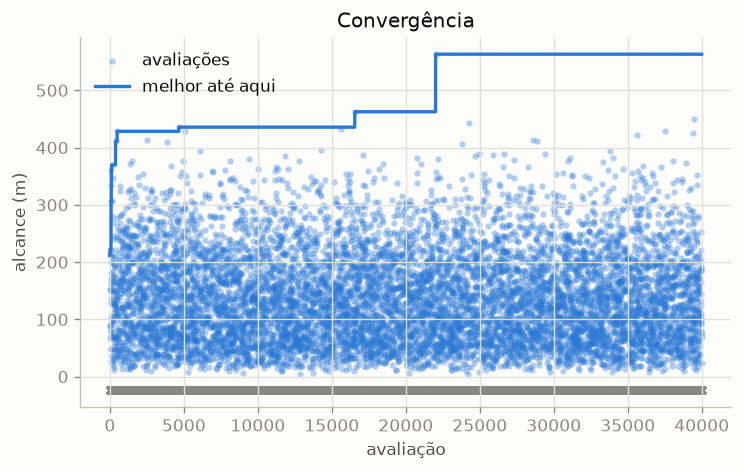
laboratorios/construivel/simulacoes/plots/run_1/convergence.png
