murilo999-666/foguetes-garrafa-pet/laboratorios/construivel/simulacoes/plots/run_1/pareto_apogee_distance.png

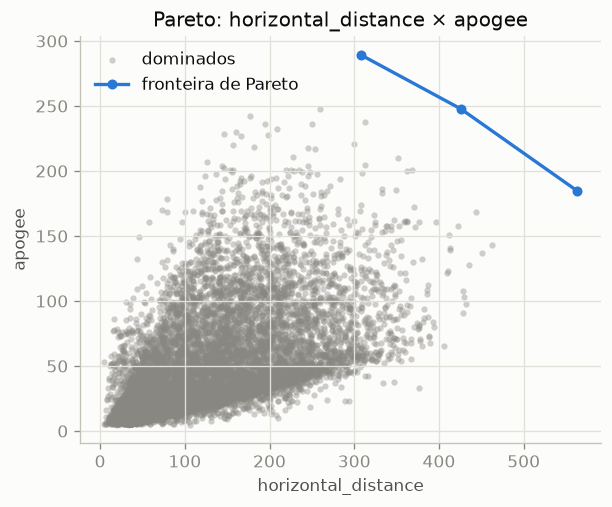
laboratorios/construivel/simulacoes/plots/run_1/pareto_apogee_distance.png
