murilo999-666/foguetes-garrafa-pet/laboratorios/construivel/simulacoes/plots/run_2/convergence.png

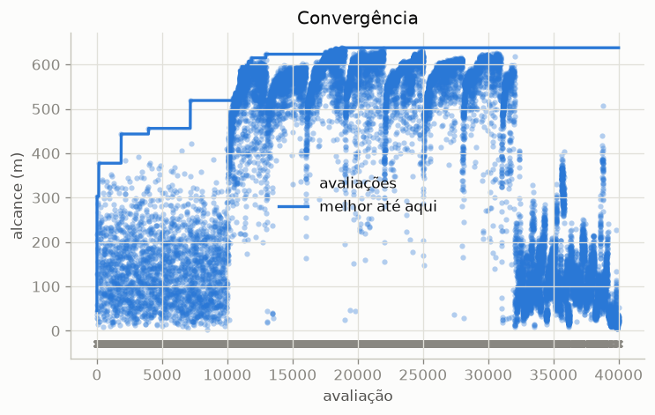
laboratorios/construivel/simulacoes/plots/run_2/convergence.png
