murilo999-666/foguetes-garrafa-pet/laboratorios/construivel/simulacoes/plots/run_2/heatmap_vinegar_fill_nozzle_diameter.png

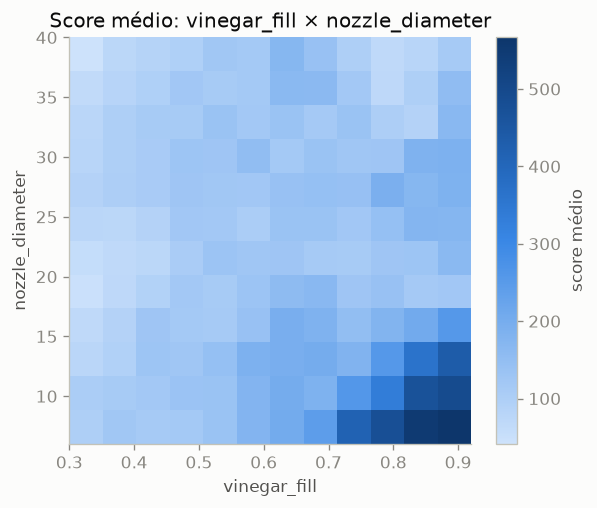
laboratorios/construivel/simulacoes/plots/run_2/heatmap_vinegar_fill_nozzle_diameter.png
