murilo999-666/foguetes-garrafa-pet/laboratorios/construivel/simulacoes/plots/run_3/heatmap_body_diameter_fin_count.png

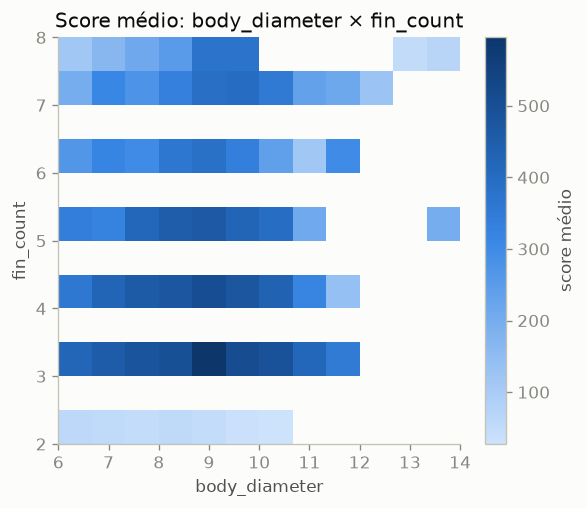
laboratorios/construivel/simulacoes/plots/run_3/heatmap_body_diameter_fin_count.png
