murilo999-666/foguetes-garrafa-pet/laboratorios/construivel/simulacoes/plots/run_3/histograms.png

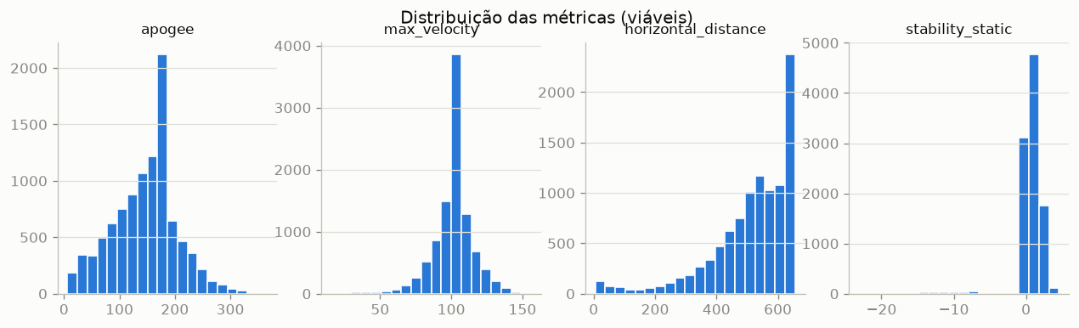
laboratorios/construivel/simulacoes/plots/run_3/histograms.png
