murilo999-666/foguetes-garrafa-pet/laboratorios/construivel/simulacoes/plots/run_3/param_effects.png

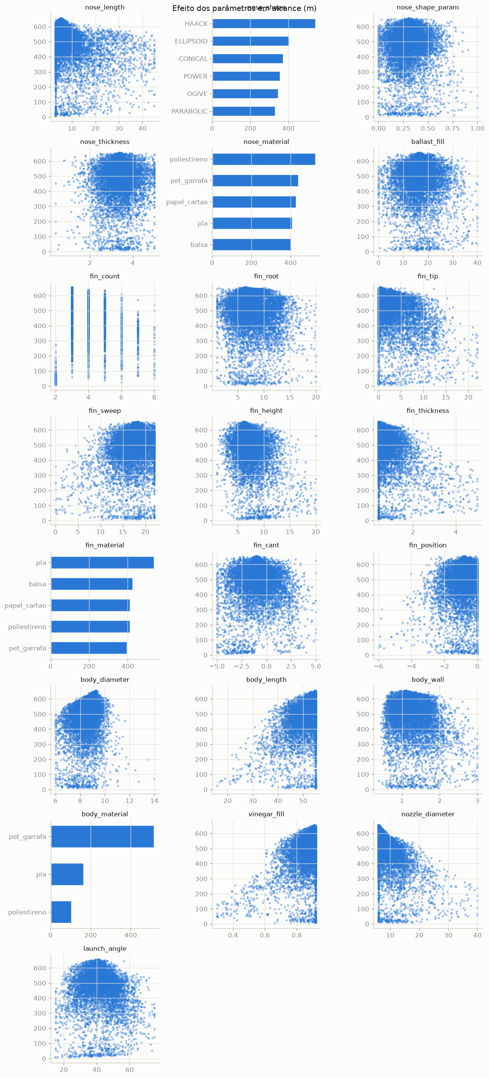
laboratorios/construivel/simulacoes/plots/run_3/param_effects.png
