murilo999-666/foguetes-garrafa-pet/docs/_LISTA_DE_COMPRAS.md

# Lista de compras — bit04 e bit05

Preços pesquisados em julho/2026. Os de Durepoxi e chapa são de varejo online e
variam por loja; os de corte a laser são orçados por trabalho (peça o orçamento
mandando o DXF).

## 1. Durepoxi (lastro na ponta da ogiva)

Quanto cada foguete precisa **de massa já misturada**:

| Foguete | Durepoxi |
|---|---|
| **bit04** (otimizado) | **416 g** |
| **bit05** (pesquisa humana) | **105 g** |
| **Os dois** | **521 g** |

Preço por grama (quanto maior a embalagem, mais barato):

| Embalagem | Preço | R$/grama |
|---|---|---|
| 50 g | R$ 13,90 | R$ 0,278 |
| 100 g | R$ 15,50 | R$ 0,155 |
| **250 g** | **R$ 26,90** | **R$ 0,108** ← melhor |

### O que comprar

| Se for construir | Compre | Total | Sobra |
|---|---|---|---|
| **só o bit04** | 2 × 250 g | **R$ 53,80** | 84 g |
| **só o bit05** | 1 × 250 g | **R$ 26,90** | 145 g |
| **os dois** | 2 × 250 g + 1 × 100 g | **R$ 69,10** | 79 g |

Detalhe que economiza dinheiro: para o bit05, **uma caixa de 250 g (R$ 26,90) sai
mais barata que 100 g + 50 g (R$ 29,40)** — e ainda sobra material.

A sobra de ~80 g não é desperdício: serve para colar as aletas, vedar e corrigir.
Durepoxi é bicomponente e a gramagem da caixa já é a soma das duas partes, então
250 g de caixa = 250 g de massa misturada.

## 2. Chapa de poliestireno 1 mm (aletas)

Área mínima que os gabaritos ocupam:

| Foguete | Área do gabarito |
|---|---|
| bit04 | 663 × 96 mm |
| bit05 | 456 × 162 mm |

Uma chapa de **40 × 60 cm** ou **50 × 50 cm** atende os dois com folga de sobra.

| Tamanho | Preço aproximado |
|---|---|
| 40 × 60 cm | ~R$ 25 – 40 |
| 50 × 50 cm | ~R$ 30 – 45 |
| 1,20 m × 60 cm | R$ 54,90 |
| 2 × 1 m | R$ 61,30 |

**Compre a menor que couber** — a de 2 × 1 m é desperdício para este projeto.
Vale perguntar à empresa do laser se ela fornece o material; muitas cortam em
chapa própria e cobram só a peça, o que costuma sair mais barato.

## 3. Corte a laser

Os arquivos DXF prontos (escala 1:1, milímetros, contorno fechado):

- `bit04 2L script/impressão/bit04_gabarito_3aletas.dxf`
- `bit05 2L humano/impressão/bit05_gabarito_3aletas.dxf`

Não achei tabela pública de preço por peça — **corte a laser é orçado por
trabalho** (tempo de máquina + material). Para peças pequenas como estas, o
valor costuma cair no **mínimo da loja**, algo entre **R$ 30 e R$ 80**. Mande o
DXF e peça orçamento; avise que é **poliestireno (PS) de 1 mm** e que a escala
é 1:1 em milímetros.

## 4. Propelente (por lançamento)

| Item | Quantidade por lançamento | Para ~10 lançamentos |
|---|---|---|
| Vinagre 4% | 1,55 L | ~16 L |
| Bicarbonato de sódio | ~200 g | ~2 kg |

Vinagre de 5 L sai por volta de R$ 12 – 18; bicarbonato de 1 kg, ~R$ 15 – 25.

## 5. Filamento PLA (ogivas impressas)

| Peça | Massa |
|---|---|
| Ogiva bit04 | 24 g |
| Ogiva bit05 | 73 g |

Com suporte e perdas, ~150 g no total — **menos de 1/6 de um rolo de 1 kg**.
Se já tiver filamento, não precisa comprar.

## 6. Não esqueça

- **Garrafa PET 2 L retornável** (e algumas reservas — a garrafa fadiga com
  pressurizações repetidas; não reutilize uma que já foi muito usada)
- **Balão ou preservativo** para separar o vinagre do bicarbonato até a hora do
  lançamento (é a técnica que a OBAFOG usa para disparar a reação na hora certa)
- **Lixa** (para dar aderência ao Durepoxi e alisar a ogiva impressa)
- **Fita crepe** e **balança de cozinha** — a balança é essencial: os 416 g de
  Durepoxi do bit04 são o que segura a estabilidade do foguete

## Resumo de custo (construindo os dois)

| Item | Custo |
|---|---|
| Durepoxi (2×250 g + 1×100 g) | R$ 69,10 |
| Chapa de poliestireno 1 mm | R$ 25 – 45 |
| Corte a laser | R$ 30 – 80 |
| Vinagre + bicarbonato (10 lançamentos) | R$ 50 – 80 |
| **Total** | **R$ 175 – 275** |

PLA e garrafas não entram porque você já tem.
