murilo999-666/foguetes-garrafa-pet/foguetes/bit03/resultados_digitais/foguete_novo_otimizacao.xlsx

Sheet: robustez_top30
nose_length | nose_shape | nose_shape_param | nose_thickness | nose_material | ballast_fill | fin_count | fin_root | fin_tip | fin_sweep | fin_height | fin_thickness | fin_material | fin_cant | fin_position | motor | alcance_seed42 | alcance_medio | alcance_desvio | alcance_pior | ventos_validos | run_id | teste
8 | POWER | 0.6797465931 | 2.614913603 | papel_cartao | 6.32288146 | 3 | 7.971225714 | 2.032053317 | 13.97293036 | 5.042993873 | 0.6017085097 | papel_cartao | 0.4672935646 | -0.4644172012 | VinagreCO2-1_5L-calib | 370.0801288 | 369.6466271 | 0.5617701076 | 368.4492781 | 20 | 6 | 19342
8 | POWER | 0.678662147 | 2.643652443 | papel_cartao | 6.314227626 | 3 | 7.909492582 | 2.015255505 | 14 | 5.026352488 | 0.6001526265 | papel_cartao | 0.4652408685 | -0.4663102977 | VinagreCO2-1_5L-calib | 369.9886034 | 369.613671 | 0.5496562166 | 368.2835157 | 20 | 6 | 14152
8 | POWER | 0.6822441978 | 2.599911826 | papel_cartao | 6.316556583 | 3 | 7.904308454 | 2.031651896 | 13.9668261 | 5.047616528 | 0.6001529489 | papel_cartao | 0.4801044146 | -0.4656892267 | VinagreCO2-1_5L-calib | 369.9397325 | 369.5557767 | 0.5642490895 | 368.5906295 | 20 | 6 | 14365
8 | POWER | 0.6771108612 | 2.658818578 | papel_cartao | 6.317744048 | 3 | 7.914864607 | 1.932110138 | 13.99676197 | 5.056347119 | 0.6001587912 | papel_cartao | 0.4601048341 | -0.4664970322 | VinagreCO2-1_5L-calib | 369.9696304 | 369.4659629 | 0.4000790451 | 368.5506804 | 20 | 6 | 14273
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
8 | POWER | 0.6445305978 | 2.647025058 | papel_cartao | 6.299847564 | 3 | 7.906294145 | 2.0066394 | 13.95452851 | 5.051327321 | 0.6001211242 | papel_cartao | 0.5211169976 | -0.4674334387 | VinagreCO2-1_5L-calib | 369.9734795 | 368.6317863 | 0.4901084952 | 367.7696907 | 20 | 6 | 13948
8 | POWER | 0.6415090991 | 2.629305042 | papel_cartao | 6.288163243 | 3 | 3.799771112 | 1.993896982 | 13.95023868 | 5.047015422 | 0.6003772656 | papel_cartao | 0.5766401421 | -0.4396570241 | VinagreCO2-1_5L-calib | 370.0456787 | 368.5776656 | 0.3981393913 | 368.0484828 | 20 | 6 | 21035

Sheet: top1000_seed42
run_id | iteration | score | nose_length | nose_shape | nose_shape_param | nose_thickness | nose_material | ballast_fill | fin_count | fin_root | fin_tip | fin_sweep | fin_height | fin_thickness | fin_material | fin_cant | fin_position | motor
6 | 14263 | 370.9246533 | 8 | POWER | 0.6790126283 | 2.612124131 | papel_cartao | 6.322019581 | 3 | 7.909761647 | 2.035499664 | 13.97206086 | 5.039671692 | 0.6001609963 | papel_cartao | 0.4668971804 | -0.4623514529 | VinagreCO2-1_5L-calib
6 | 25446 | 370.6191904 | 8 | POWER | 0.6791521927 | 2.616285212 | papel_cartao | 6.278738866 | 3 | 7.8966219 | 2.03063799 | 13.96810779 | 5.040968972 | 0.6006906718 | papel_cartao | 0.457439966 | -0.4236508201 | VinagreCO2-1_5L-calib
6 | 14433 | 370.6110809 | 8 | POWER | 0.675756781 | 2.619303447 | papel_cartao | 6.316517492 | 3 | 7.564837807 | 2.091427613 | 13.98126149 | 5.049712905 | 0.6001604103 | papel_cartao | 0.4776663466 | -0.4395836222 | VinagreCO2-1_5L-calib
6 | 28960 | 370.557044 | 8.051957559 | POWER | 0.6790801174 | 2.62617381 | papel_cartao | 6.334611921 | 3 | 7.917138372 | 2.030615544 | 13.97238703 | 5.048195097 | 0.6007971709 | papel_cartao | 0.6203073365 | -0.4672781522 | VinagreCO2-1_5L-calib
6 | 14174 | 370.49476 | 8 | POWER | 0.6788772723 | 2.616931224 | papel_cartao | 6.316884436 | 3 | 7.899851485 | 2.11095896 | 13.97841654 | 5.045640707 | 0.6001634455 | papel_cartao | 0.4808203389 | -0.4659329231 | VinagreCO2-1_5L-calib
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
6 | 13895 | 368.2158723 | 8 | POWER | 0.6574215793 | 2.579682761 | papel_cartao | 6.314369909 | 3 | 7.917855052 | 2.044582664 | 13.93192834 | 5.242661889 | 0.6001554325 | papel_cartao | 0.4835315693 | -0.4669235524 | VinagreCO2-1_5L-calib

Sheet: resumo_runs
id | name | algorithm | status | notes
1 | bit03-livre-10000 | adaptive | done | melhor horizontal_distance=369.5 em {"nose_length": 8.384994246257829, "nose_shape": "PARABOLIC", "nose_shape_param": 0.5828672737840825, "nose_thickness": 2.862035622621627, "nose_material": "pla", "ballast_fill": 6.384928846974022, "fin_count": 3, "fin_root": 11.405714061953393, "fin_tip": 1.488314733212603, "fin_sweep": 13.99190486362836, "fin_height": 5.004113882104431, "fin_thickness": 0.6951936198464878, "fin_material": "papel_cartao", "fin_cant": 1.565300834207088, "fin_position": -0.11274871870733957, "motor": "VinagreCO2-1_5L-calib"}
2 | mega-adaptive-65k | adaptive | done | melhor horizontal_distance=338.4 em {"nose_length": 34.21846588848168, "nose_shape": "PARABOLIC", "nose_shape_param": 0.2972599318510503, "nose_thickness": 2.1577743095945956, "nose_material": "poliestireno", "ballast_fill": 15.976111277808656, "fin_count": 3, "fin_root": 6.990969850823513, "fin_tip": 1.430697164718318, "fin_sweep": 4.858235484726548, "fin_height": 8.708653342044768, "fin_thickness": 0.641519757384018, "fin_material": "pla", "fin_cant": 1.2942684223010885, "fin_position": -1.32784030132148, "motor": "VinagreCO2-1_5L-calib"}
3 | mega-genetic-35k | genetic | done | melhor horizontal_distance=338 em {"nose_length": 26.97480262298852, "nose_shape": "HAACK", "nose_shape_param": 0.4054947304074451, "nose_thickness": 0.6, "nose_material": "poliestireno", "ballast_fill": 10.613660566569296, "fin_count": 3, "fin_root": 2.0, "fin_tip": 5.019015755495346, "fin_sweep": 10.052732394288586, "fin_height": 8.855748390719917, "fin_thickness": 0.7791537568209727, "fin_material": "pet_garrafa", "fin_cant": -1.0752034232061016, "fin_position": -2.5680360220069116, "motor": "VinagreCO2-1_5L-calib"}
4 | mega-adaptive-65k | adaptive | aborted | morto externamente ~30.5k evals
5 | mega-adaptive-35000 | adaptive | done | melhor horizontal_distance=368.8 em {"nose_length": 8.578231513438471, "nose_shape": "PARABOLIC", "nose_shape_param": 0.5276789718249782, "nose_thickness": 1.3806949315834507, "nose_material": "papel_cartao", "ballast_fill": 6.544328813375656, "fin_count": 3, "fin_root": 6.637935310927845, "fin_tip": 6.005747507945485, "fin_sweep": 12.963440301646283, "fin_height": 5.0729440323547275, "fin_thickness": 0.6000370967796386, "fin_material": "papel_cartao", "fin_cant": -0.3741971030534531, "fin_position": -1.236824100550763, "motor": "VinagreCO2-1_5L-calib"}
6 | mega-genetic-35000 | genetic | done | melhor horizontal_distance=370.9 em {"nose_length": 8.0, "nose_shape": "POWER", "nose_shape_param": 0.6790126282758268, "nose_thickness": 2.612124131450483, "nose_material": "papel_cartao", "ballast_fill": 6.322019581205261, "fin_count": 3, "fin_root": 7.909761647027698, "fin_tip": 2.035499664011714, "fin_sweep": 13.972060858700072, "fin_height": 5.039671691857986, "fin_thickness": 0.6001609962708561, "fin_material": "papel_cartao", "fin_cant": 0.46689718038782047, "fin_position": -0.4623514529482836, "motor": "VinagreCO2-1_5L-calib"}
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
