murilo999-666/foguetes-garrafa-pet/base-de-lancamento/base de lançamento obafog.step

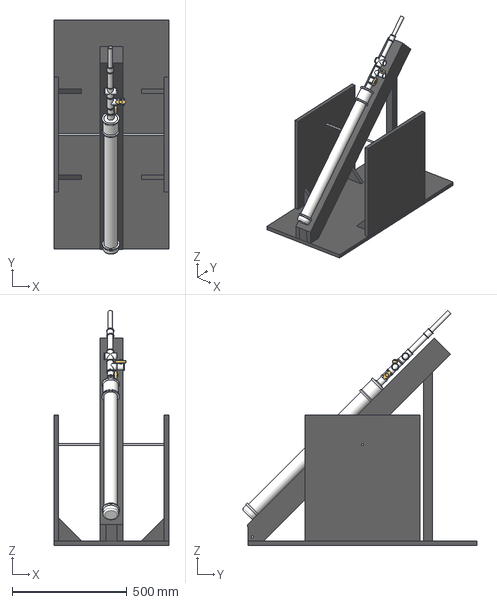
[picture p100: CAD file, 2026-08-12]
base-de-lancamento/base de lançamento obafog.step
500.1 x 1022.4 x 1024.6 mm
