murilo999-666/foguetes-garrafa-pet/docs/geral/gabarito aletas.dxf

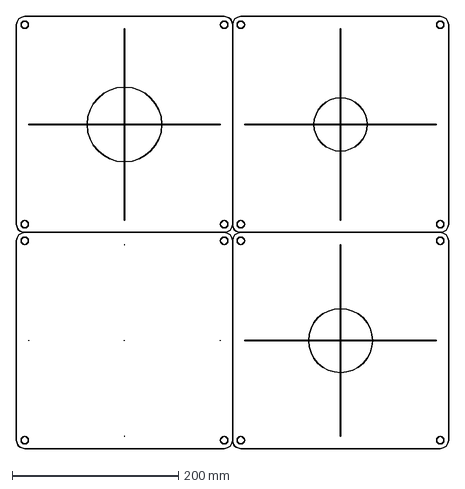
[picture p101: CAD file, 2026-08-12]
docs/geral/gabarito aletas.dxf
520.0 x 520.0 mm
