murilo999-666/foguetes-garrafa-pet/docs/geral/gabarito3d/gabarito_aletas_bocal.stl

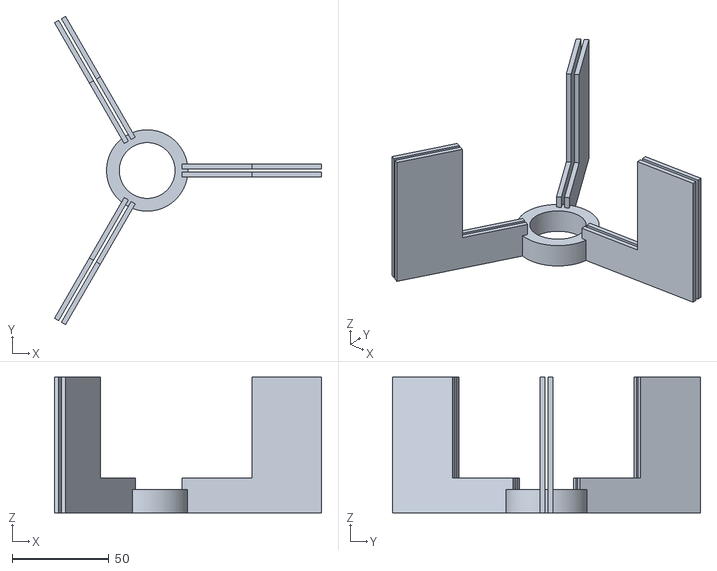
[picture p102: CAD file, 2026-08-12]
docs/geral/gabarito3d/gabarito_aletas_bocal.stl
137.9 x 159.2 x 70.0
