murilo999-666/foguetes-garrafa-pet/foguetes/bit01/ogivas2.stl

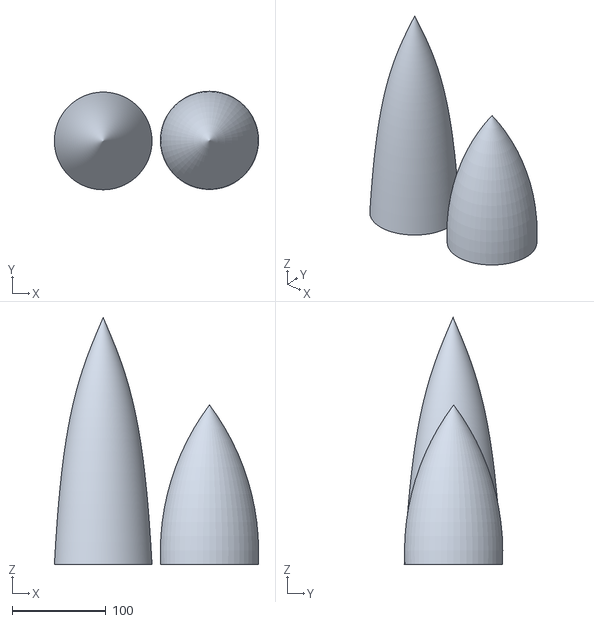
[picture p103: CAD file, 2026-08-12]
foguetes/bit01/ogivas2.stl
217.5 x 104.9 x 263.1
