murilo999-666/foguetes-garrafa-pet/foguetes/bit02/ogive180.stl

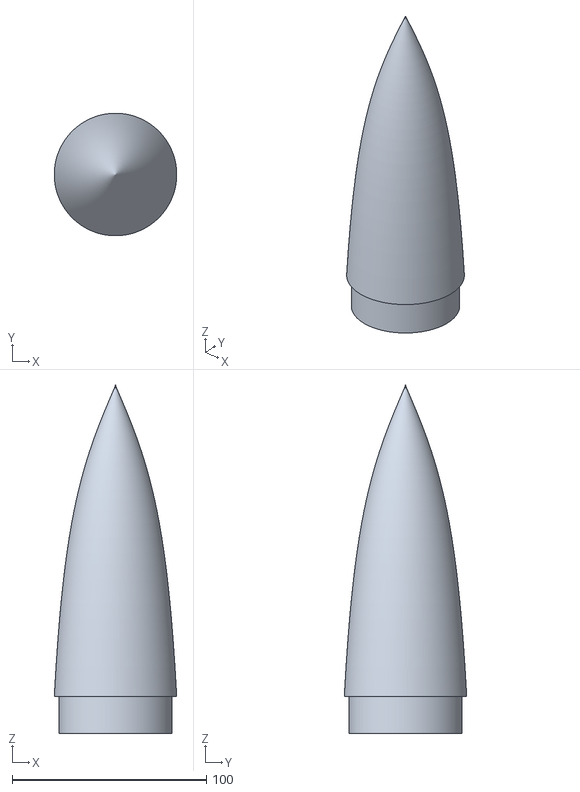
[picture p104: CAD file, 2026-08-12]
foguetes/bit02/ogive180.stl
63.0 x 63.0 x 179.0
