murilo999-666/foguetes-garrafa-pet/foguetes/bit03/2ogiva.stl

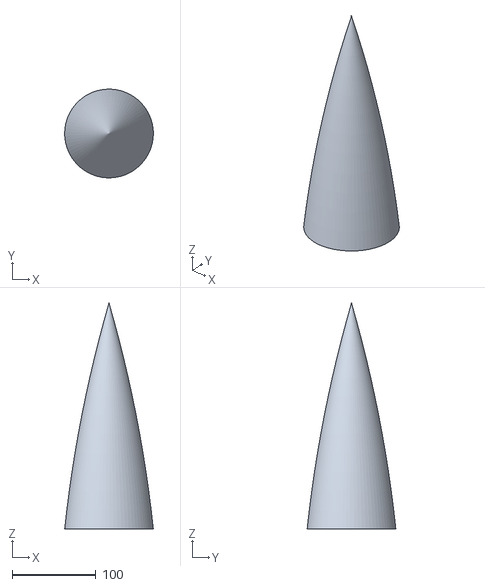
[picture p105: CAD file, 2026-08-12]
foguetes/bit03/2ogiva.stl
105.9 x 106.0 x 270.0
