murilo999-666/foguetes-garrafa-pet/foguetes/bit06-1.8L/_ENTREGUE_16ago_2245/impressao_PET/bit06pet_aleta_molde.dxf

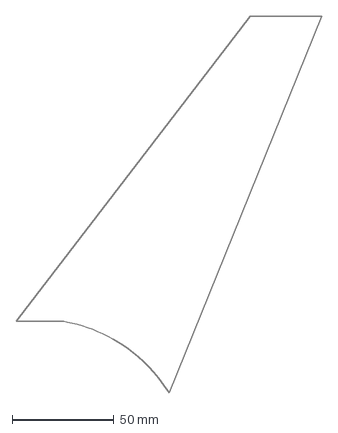
[picture p106: CAD file, 2026-08-17]
foguetes/bit06-1.8L/_ENTREGUE_16ago_2245/impressao_PET/bit06pet_aleta_molde.dxf
150.0 x 185.1 mm
