murilo999-666/foguetes-garrafa-pet/foguetes/bit06-1.8L/_PET_v1_descartado/impressao_PET/bit06pet_coifa.stl

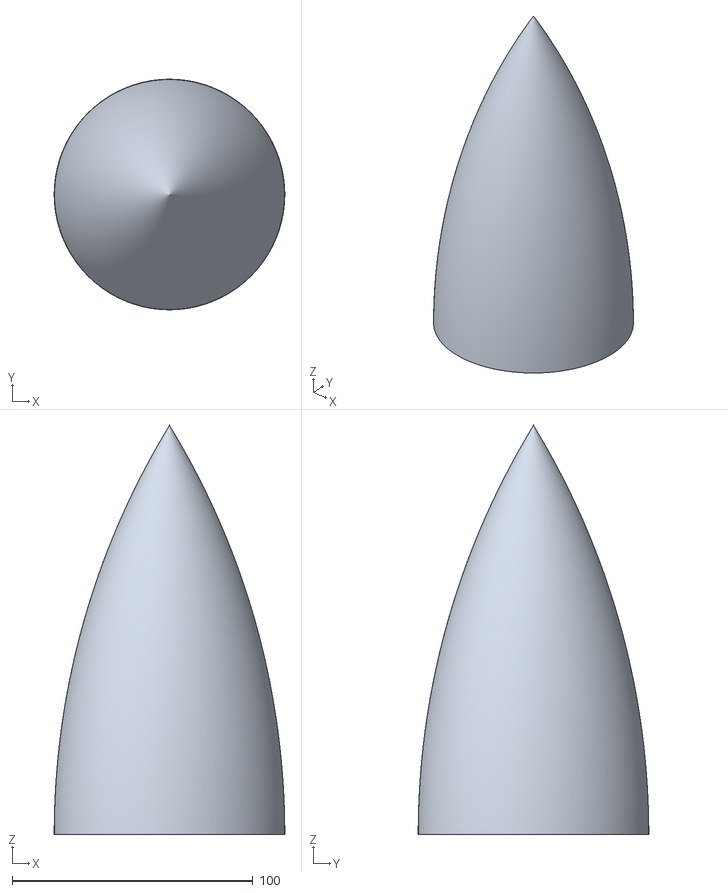
[picture p107: CAD file, 2026-08-17]
foguetes/bit06-1.8L/_PET_v1_descartado/impressao_PET/bit06pet_coifa.stl
95.8 x 95.8 x 170.0
