murilo999-666/foguetes-garrafa-pet/foguetes/bit06-1.8L/impressao/bit06_aleta_molde.dxf

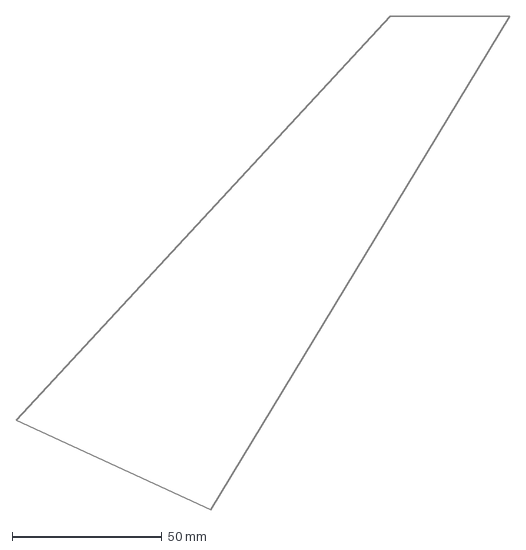
[picture p108: CAD file, 2026-08-12]
foguetes/bit06-1.8L/impressao/bit06_aleta_molde.dxf
165.0 x 164.8 mm
