murilo999-666/foguetes-garrafa-pet/foguetes/bit06-1.8L/impressao_PET/bit06pet_aletas_3x.dxf

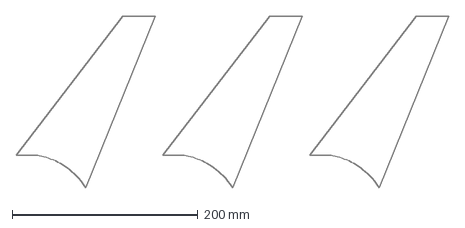
[picture p109: CAD file, 2026-08-17]
foguetes/bit06-1.8L/impressao_PET/bit06pet_aletas_3x.dxf
466.0 x 185.1 mm
