murilo999-666/foguetes-garrafa-pet/foguetes/bit07-2L/impressão/bit07_B/bit07_B_coifa.stl

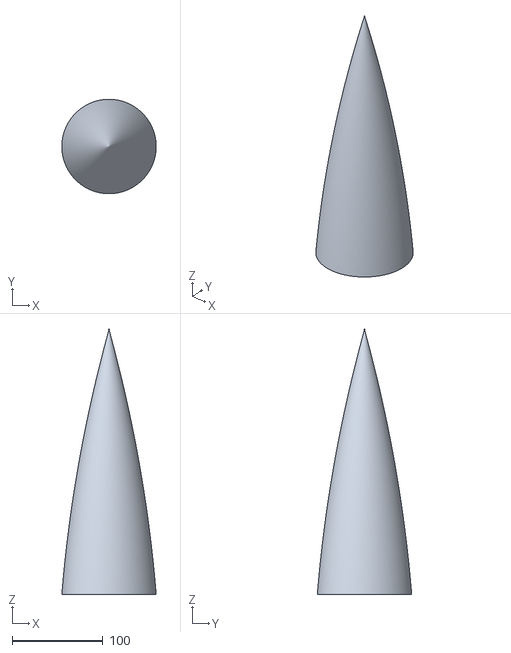
[picture p110: CAD file, 2026-08-17]
foguetes/bit07-2L/impressão/bit07_B/bit07_B_coifa.stl
104.0 x 104.0 x 292.0
