murilo999-666/foguetes-garrafa-pet/foguetes/bit07-2L/impressão/bit07_gabarito_3aletas.dxf

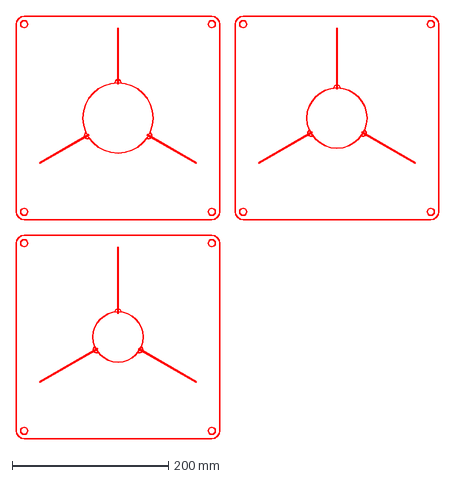
[picture p111: CAD file, 2026-08-12]
foguetes/bit07-2L/impressão/bit07_gabarito_3aletas.dxf
540.0 x 540.0 mm
