murilo999-666/foguetes-garrafa-pet/foguetes/bit07-2L/impressão/margem_extra/bit07E_coifa.stl

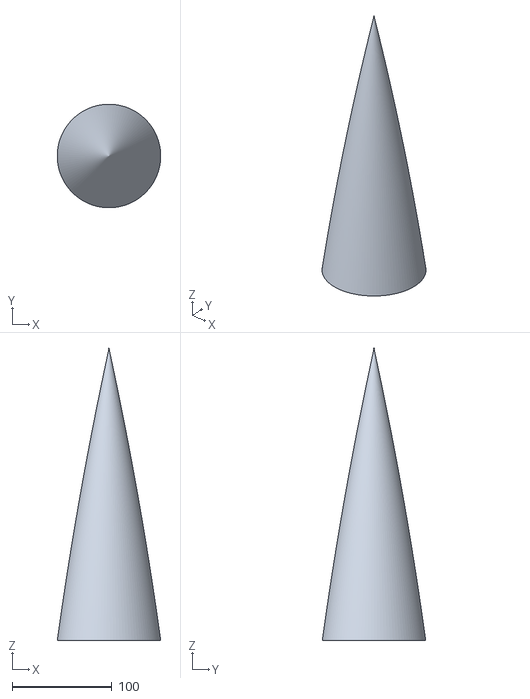
[picture p112: CAD file, 2026-08-12]
foguetes/bit07-2L/impressão/margem_extra/bit07E_coifa.stl
104.0 x 104.0 x 293.5
