murilo999-666/foguetes-garrafa-pet/foguetes/bit07-2L/impressão/MODELO_FINAL/bit07_final_coifa.stl

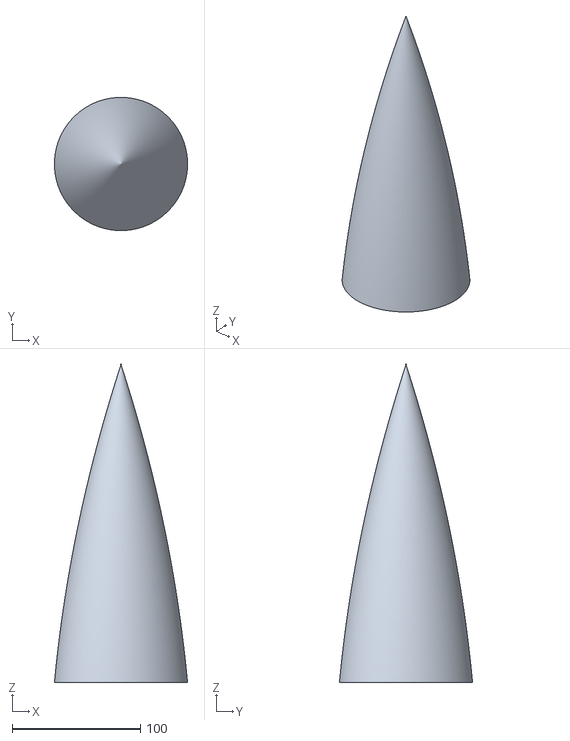
[picture p113: CAD file, 2026-08-12]
foguetes/bit07-2L/impressão/MODELO_FINAL/bit07_final_coifa.stl
104.0 x 104.0 x 248.3
