murilo999-666/foguetes-garrafa-pet/foguetes/bit08/coifa_PARTIDA_1_base.stl

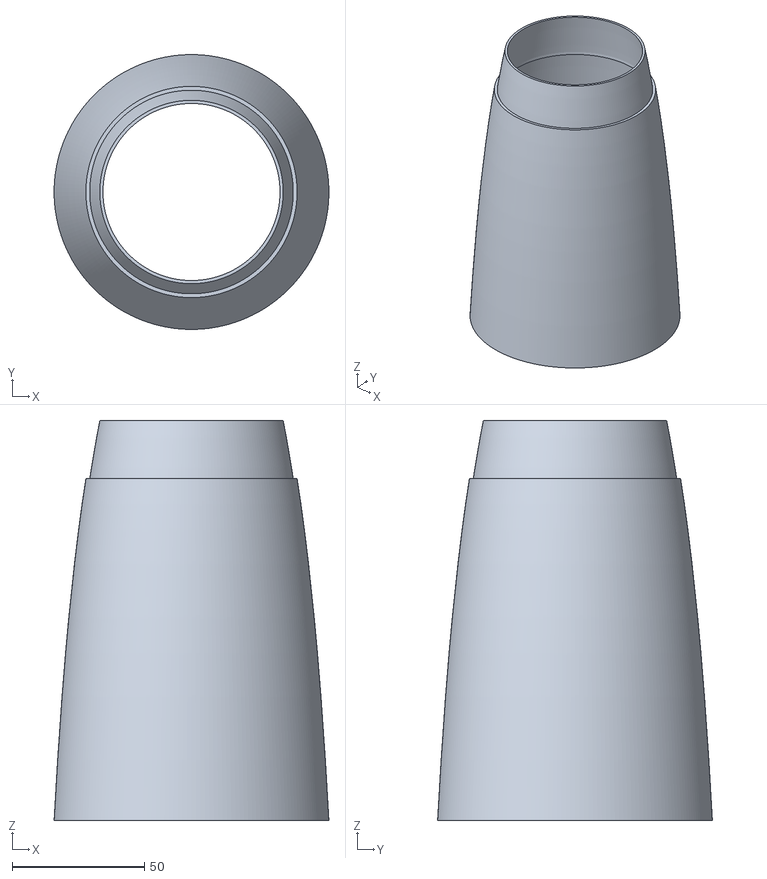
[picture p114: CAD file, 2026-08-23]
foguetes/bit08/coifa_PARTIDA_1_base.stl
103.9 x 103.9 x 151.2
