murilo999-666/foguetes-garrafa-pet/foguetes/bit09/coifa_INTEIRA_parede1.2mm.stl

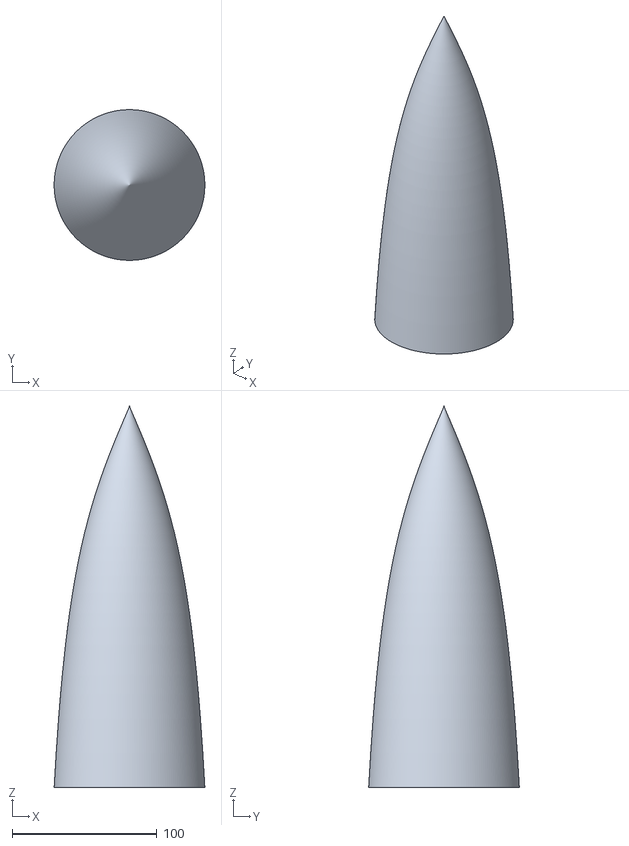
[picture p115: CAD file, 2026-08-23]
foguetes/bit09/coifa_INTEIRA_parede1.2mm.stl
104.0 x 104.0 x 262.9
