murilo999-666/foguetes-garrafa-pet/docs/geral/gabarito3d/gabarito_copo_3aletas.stl

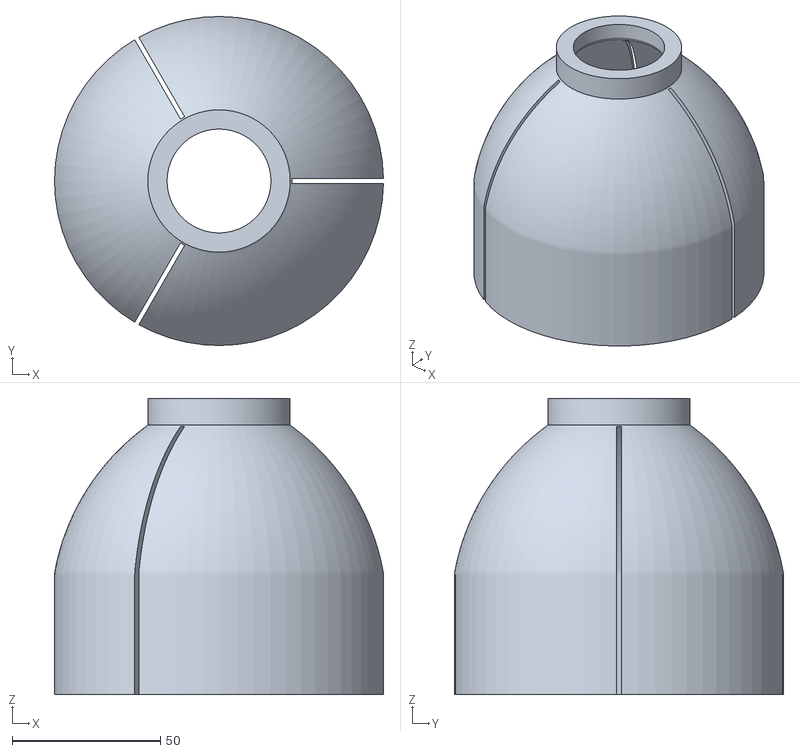
[picture p116: CAD file, 2026-08-12]
docs/geral/gabarito3d/gabarito_copo_3aletas.stl
111.0 x 111.0 x 100.0
