murilo999-666/foguetes-garrafa-pet/foguetes/bit01/ogiva-murilo.stl

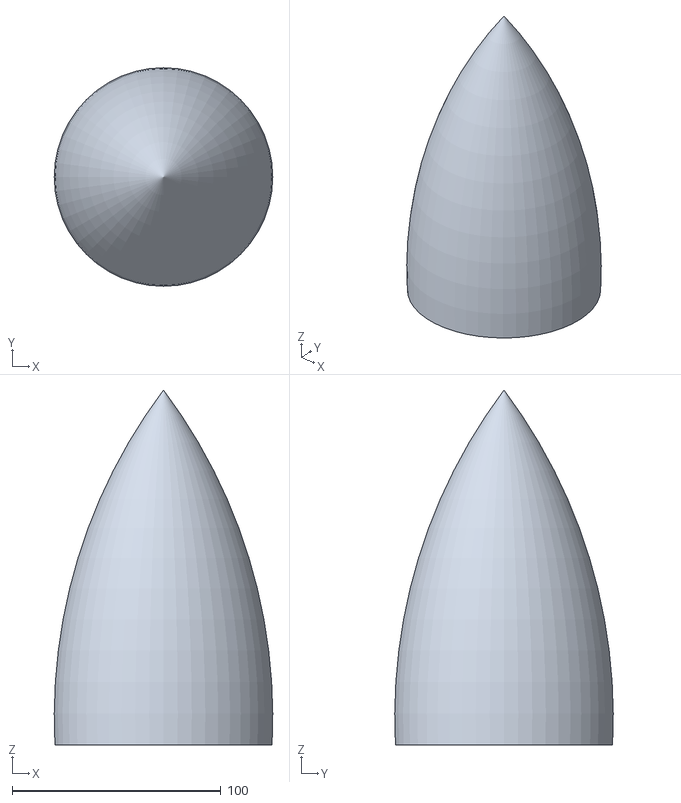
[picture p117: CAD file, 2026-08-12]
foguetes/bit01/ogiva-murilo.stl
104.7 x 104.7 x 170.0
