murilo999-666/foguetes-garrafa-pet/foguetes/bit02/ogiva-internet.stl

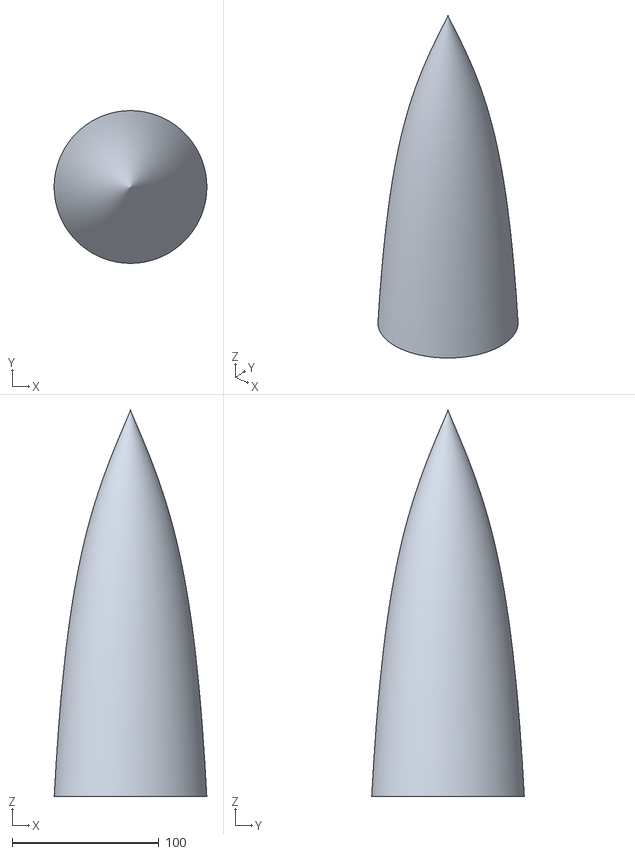
[picture p118: CAD file, 2026-08-12]
foguetes/bit02/ogiva-internet.stl
104.0 x 104.0 x 263.0
