murilo999-666/foguetes-garrafa-pet/foguetes/bit03/aletasnovas.stl

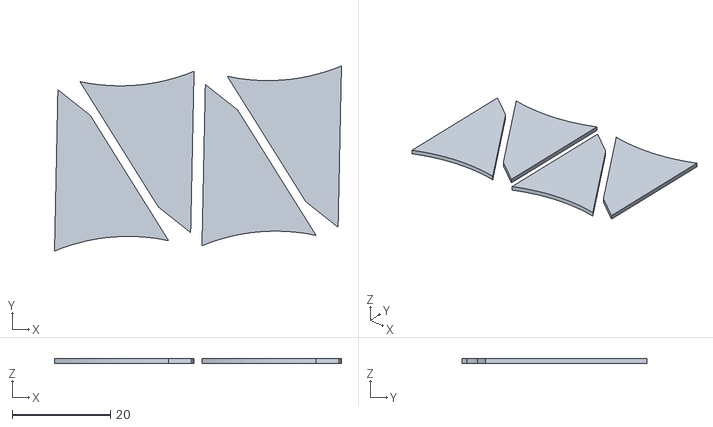
[picture p119: CAD file, 2026-08-12]
foguetes/bit03/aletasnovas.stl
58.4 x 37.7 x 1.00
