murilo999-666/foguetes-garrafa-pet/foguetes/bit04-2L/impressão/bit04_aletas.stl

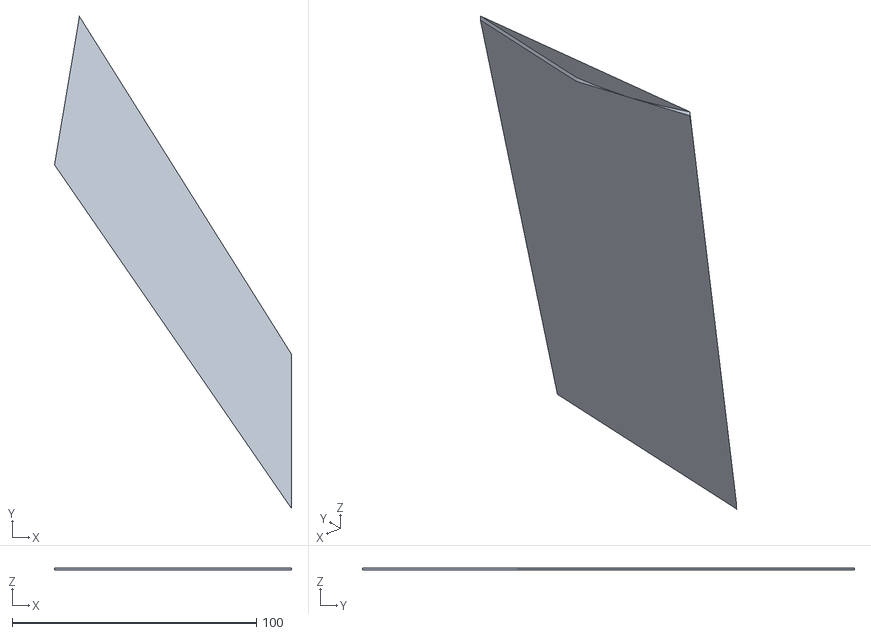
[picture p120: CAD file, 2026-08-12]
foguetes/bit04-2L/impressão/bit04_aletas.stl
97.0 x 201.3 x 1.00
