murilo999-666/foguetes-garrafa-pet/foguetes/bit05-2L/impressão/bit05_aletas.stl

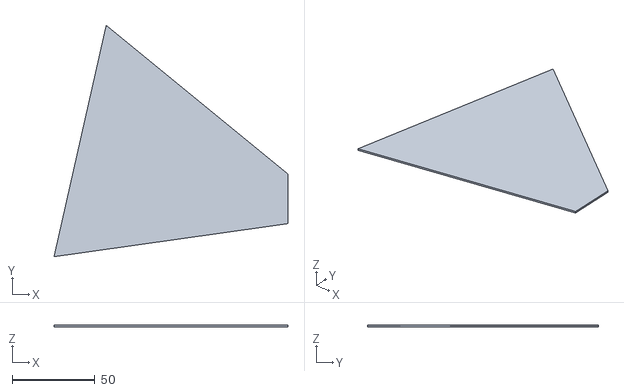
[picture p121: CAD file, 2026-08-12]
foguetes/bit05-2L/impressão/bit05_aletas.stl
141.6 x 140.0 x 1.00
