murilo999-666/foguetes-garrafa-pet/foguetes/bit06-1.8L/impressao/bit06_coifa_parte1_base.stl

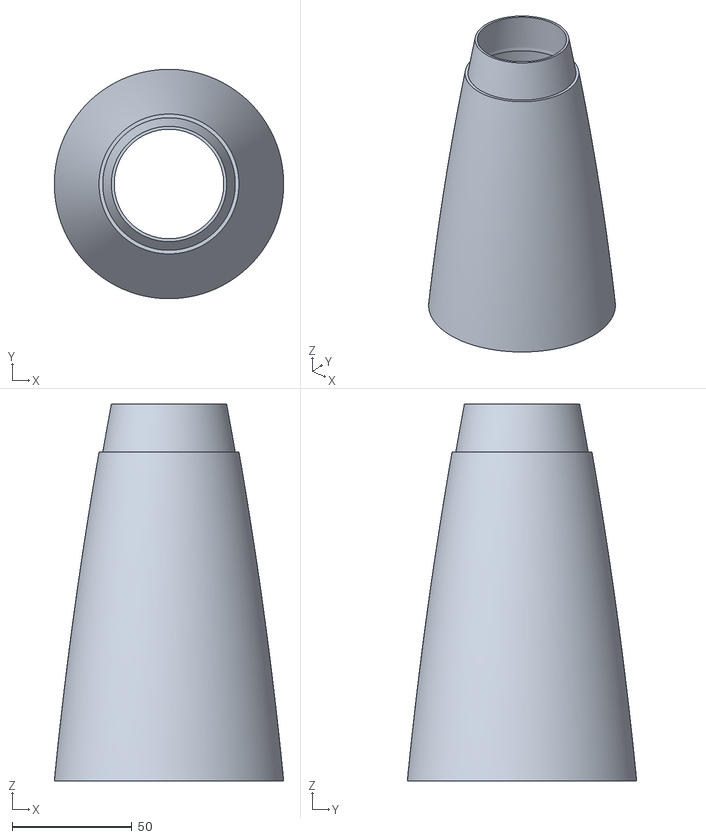
[picture p122: CAD file, 2026-08-12]
foguetes/bit06-1.8L/impressao/bit06_coifa_parte1_base.stl
95.8 x 95.8 x 157.5
