murilo999-666/foguetes-garrafa-pet/foguetes/bit06-1.8L/impressao_PET/bit06pet_coifa.stl

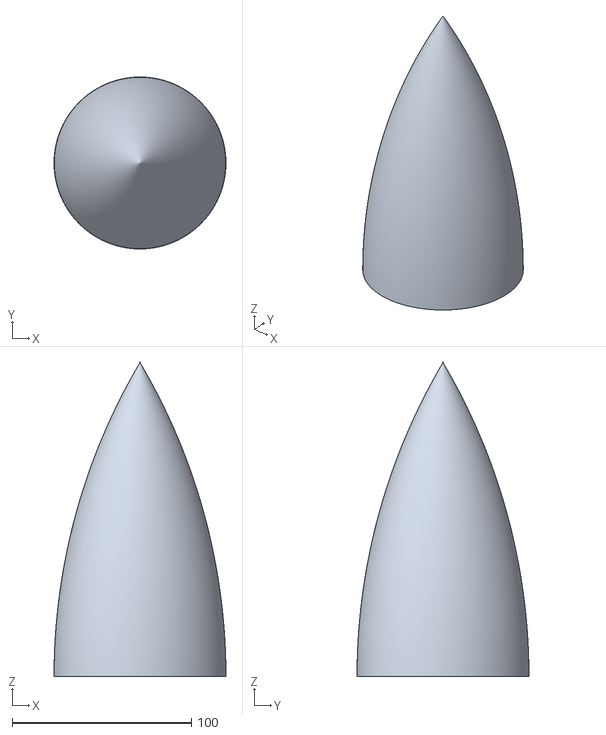
[picture p123: CAD file, 2026-08-17]
foguetes/bit06-1.8L/impressao_PET/bit06pet_coifa.stl
95.8 x 95.8 x 175.0
