murilo999-666/foguetes-garrafa-pet/foguetes/bit07-2L/impressão/bit07_B/bit07_B_coifa_parte1_base.stl

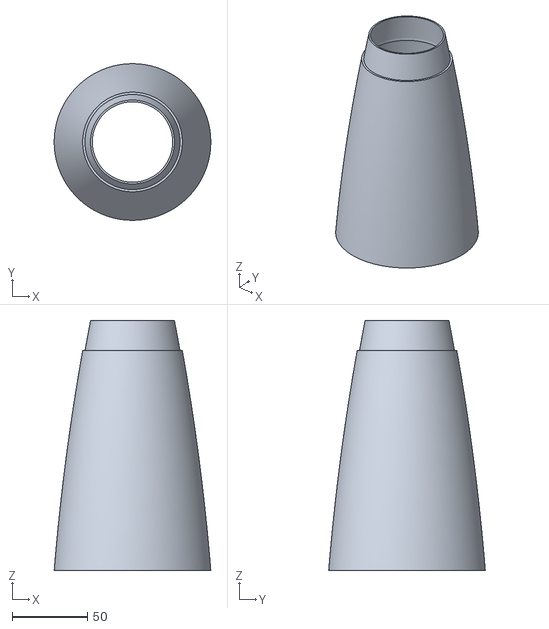
[picture p124: CAD file, 2026-08-17]
foguetes/bit07-2L/impressão/bit07_B/bit07_B_coifa_parte1_base.stl
104.0 x 104.0 x 166.0
