murilo999-666/foguetes-garrafa-pet/foguetes/bit07-2L/impressão/margem_extra/bit07E_aletas.stl

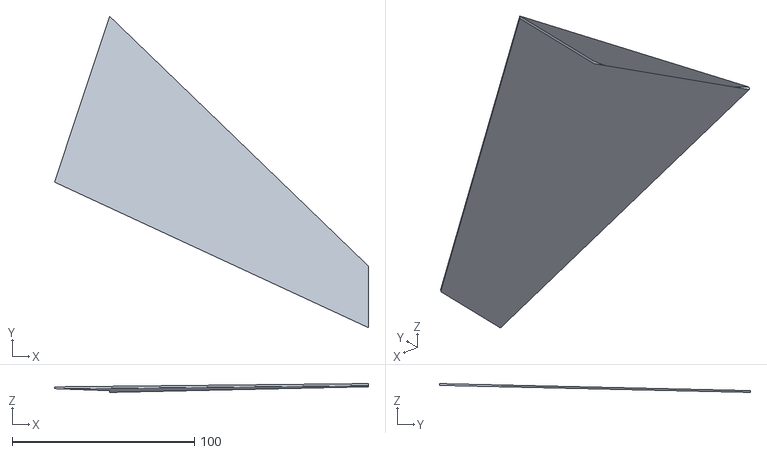
[picture p125: CAD file, 2026-08-12]
foguetes/bit07-2L/impressão/margem_extra/bit07E_aletas.stl
172.3 x 170.9 x 4.85
