murilo999-666/foguetes-garrafa-pet/foguetes/bit07-2L/impressão/MODELO_FINAL/bit07_final_aleta_molde.dxf

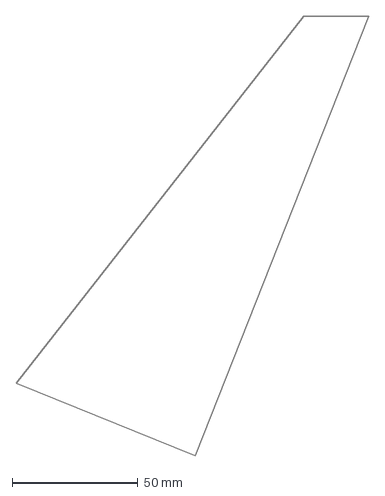
[picture p126: CAD file, 2026-08-12]
foguetes/bit07-2L/impressão/MODELO_FINAL/bit07_final_aleta_molde.dxf
140.4 x 175.2 mm
