murilo999-666/foguetes-garrafa-pet/foguetes/bit08/coifa_PARTIDA_2_ponta.stl

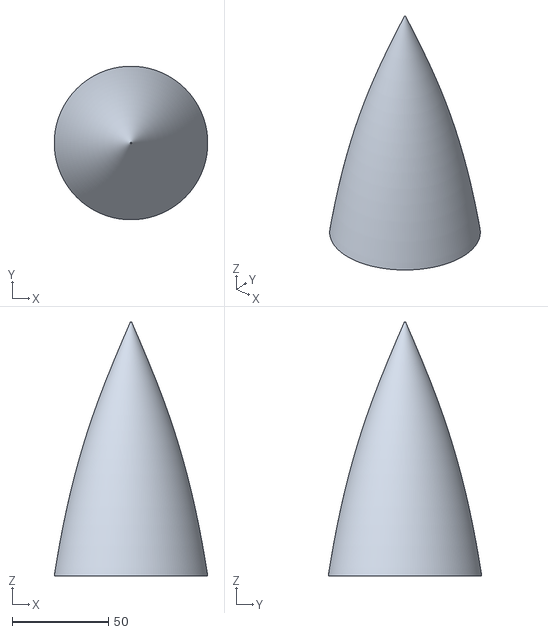
[picture p127: CAD file, 2026-08-23]
foguetes/bit08/coifa_PARTIDA_2_ponta.stl
79.9 x 79.9 x 132.2
