murilo999-666/foguetes-garrafa-pet/foguetes/bit06-1.8L/impressao/bit06_coifa_parte2_ponta.stl

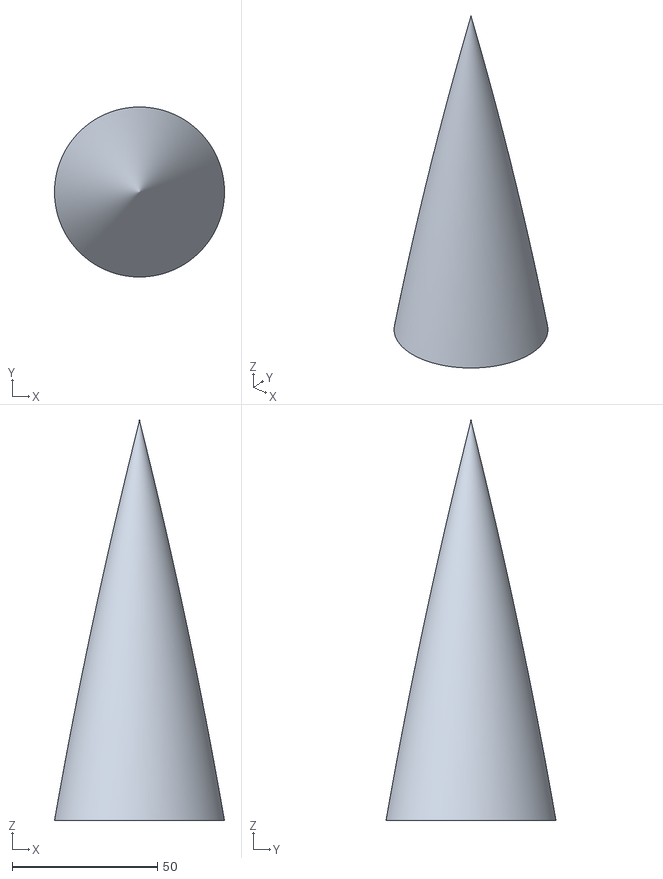
[picture p129: CAD file, 2026-08-12]
foguetes/bit06-1.8L/impressao/bit06_coifa_parte2_ponta.stl
58.4 x 58.4 x 137.5
