murilo999-666/foguetes-garrafa-pet/foguetes/bit07-2L/impressão/bit07_B/bit07_B_coifa_parte2_ponta.stl

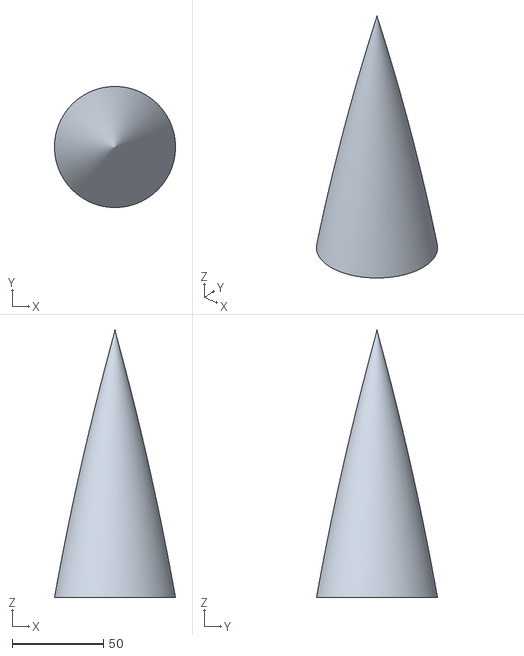
[picture p130: CAD file, 2026-08-17]
foguetes/bit07-2L/impressão/bit07_B/bit07_B_coifa_parte2_ponta.stl
66.2 x 66.2 x 146.0
