murilo999-666/foguetes-garrafa-pet/foguetes/bit06-1.8L/impressao/bit06_aletas_3x.dxf

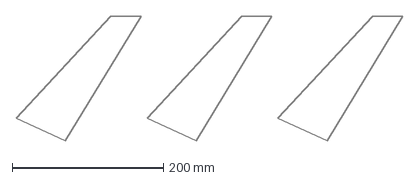
[picture p132: CAD file, 2026-08-12]
foguetes/bit06-1.8L/impressao/bit06_aletas_3x.dxf
511.0 x 164.8 mm
