murilo999-666/foguetes-garrafa-pet/foguetes/bit07-2L/impressão/MODELO_FINAL/bit07_final_coifa_parte2_ponta.stl

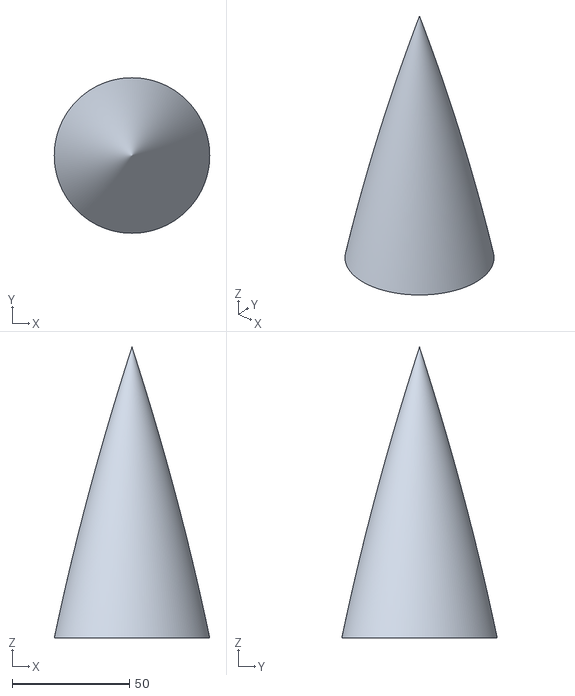
[picture p133: CAD file, 2026-08-12]
foguetes/bit07-2L/impressão/MODELO_FINAL/bit07_final_coifa_parte2_ponta.stl
66.4 x 66.4 x 124.2
