murilo999-666/foguetes-garrafa-pet/foguetes/bit06-1.8L/impressao/bit06_coifa.stl

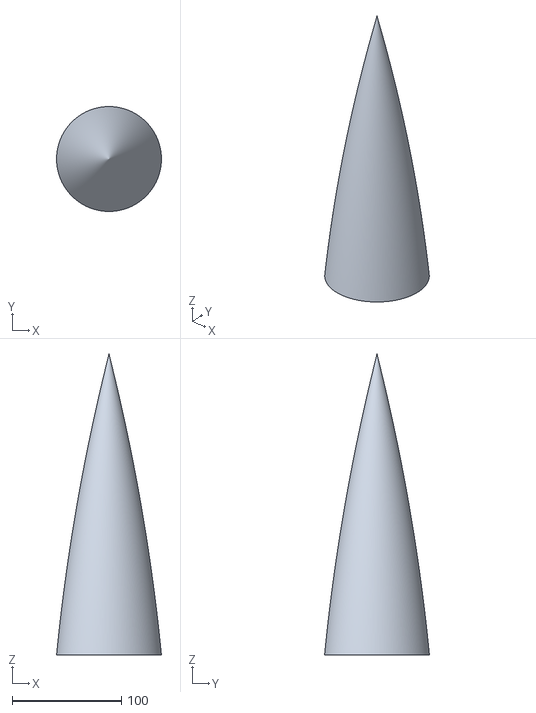
[picture p134: CAD file, 2026-08-12]
foguetes/bit06-1.8L/impressao/bit06_coifa.stl
95.8 x 95.8 x 275.0
