murilo999-666/foguetes-garrafa-pet/foguetes/bit07-2L/impressão/MODELO_FINAL/bit07_final_aletas_3x.dxf

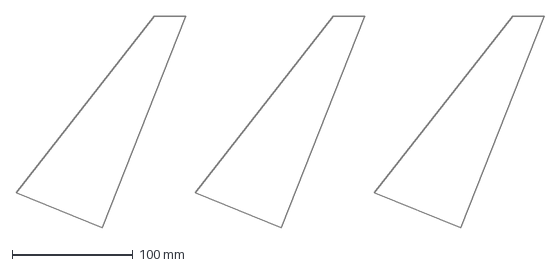
[picture p135: CAD file, 2026-08-12]
foguetes/bit07-2L/impressão/MODELO_FINAL/bit07_final_aletas_3x.dxf
437.3 x 175.2 mm
