murilo999-666/foguetes-garrafa-pet/foguetes/bit07-2L/impressão/bit07_B/bit07_B_aleta_molde.dxf

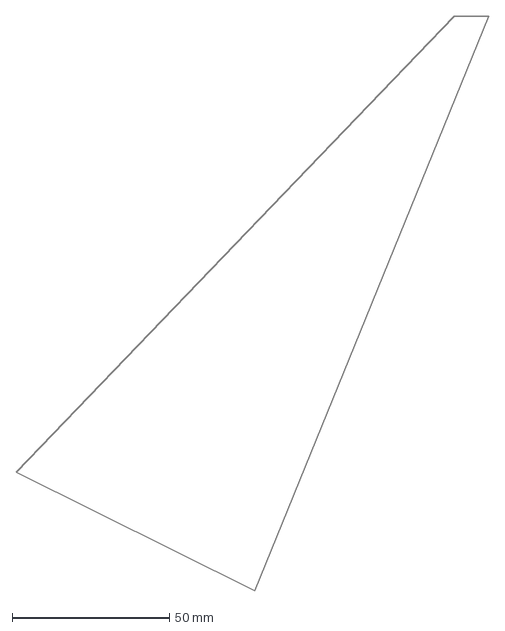
[picture p136: CAD file, 2026-08-12]
foguetes/bit07-2L/impressão/bit07_B/bit07_B_aleta_molde.dxf
150.2 x 182.8 mm
