murilo999-666/foguetes-garrafa-pet/foguetes/bit07-2L/impressão/bit07_B/bit07_B_aletas_4x.dxf

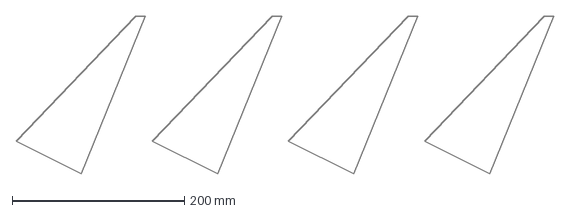
[picture p137: CAD file, 2026-08-12]
foguetes/bit07-2L/impressão/bit07_B/bit07_B_aletas_4x.dxf
624.8 x 182.8 mm
