murilo999-666/foguetes-garrafa-pet/(list of files, cad)

Other CAD files:
foguetes/bit04-2L/foguete_real/impressão_molde/coifa_foguete_real_otimizado.obj
foguetes/bit04-2L/impressão/bit04_gabarito_3aletas.dxf
foguetes/bit05-2L/impressão/bit05_coifa.stl
foguetes/bit07-2L/impressão/bit07_coifa.stl
foguetes/bit04-2L/impressão/bit04_coifa.stl
foguetes/bit05-2L/impressão/bit05_gabarito_3aletas.dxf
foguetes/bit07-2L/impressão/bit07_B/bit07_B_coifa_PLA_parte2_ponta.stl
foguetes/bit07-2L/impressão/bit07_B/bit07_B_coifa_PLA.stl
foguetes/bit07-2L/impressão/bit07_B/bit07_B_coifa_PLA_parte1_base.stl
base-de-lancamento/base de lançamento obafog.f3d
base-de-lancamento/base de lançamento obafog.stl
docs/geral/gabarito_aletas.dxf
