murilo999-666/foguetes-garrafa-pet/foguetes/bit07-2L/versoes_teste/ranking_bit07_v1.csv

nota | alcance_medio | alcance_pior | massa_seca_g | estab_min | estab_max | trilho_min | alcance_130psi | alcance_140psi | alcance_150psi | alcance_160psi | alcance_170psi | alcance_180psi | nose_length | nose_shape | nose_shape_param | nose_thickness | nose_material | ballast_fill | fin_count | fin_root | fin_tip | fin_sweep | fin_height | fin_thickness | fin_material | fin_cant | fin_position | motor | launch_angle
66.16 | 318.9 | 294.2 | 432.7 | 1.0 | 1.797 | 39.47 | 294.2 | 303.9 | 315.8 | 323.8 | 334.6 | 340.9 | 26.876032846569988 | PARABOLIC | 0.821390206461027 | 2.998749044958675 | pla | 9.97604041927046 | 4 | 8.013865722130042 | 3.4255993678074694 | 12.418585008020425 | 10.023396057452423 | 0.6667985482119091 | pla | 1.3005741042877703 | -1.4260102305805342 | file:D:\OBAFOG\bit07 robusto 2L\motores\Bit07-L1_10-P140.eng | 52.375476858098295
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
