murilo999-666/foguetes-garrafa-pet/laboratorios/testes-livres/simulacoes/plots/run_2/convergence.png

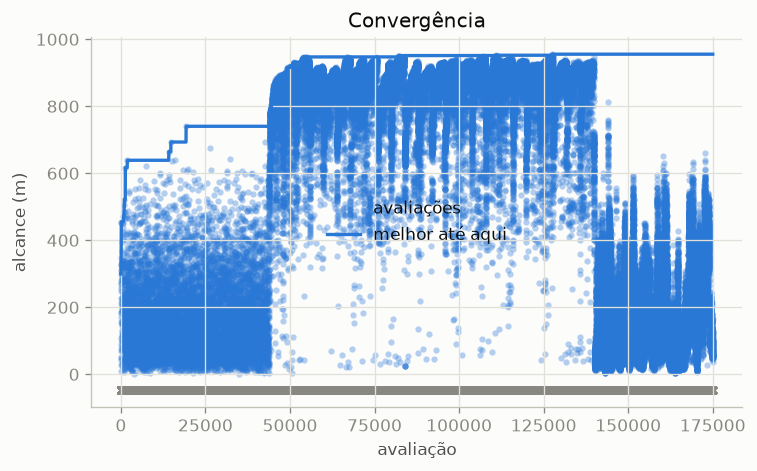
laboratorios/testes-livres/simulacoes/plots/run_2/convergence.png
