murilo999-666/foguetes-garrafa-pet/laboratorios/testes-livres/simulacoes/plots/run_2/pareto_apogee_distance.png

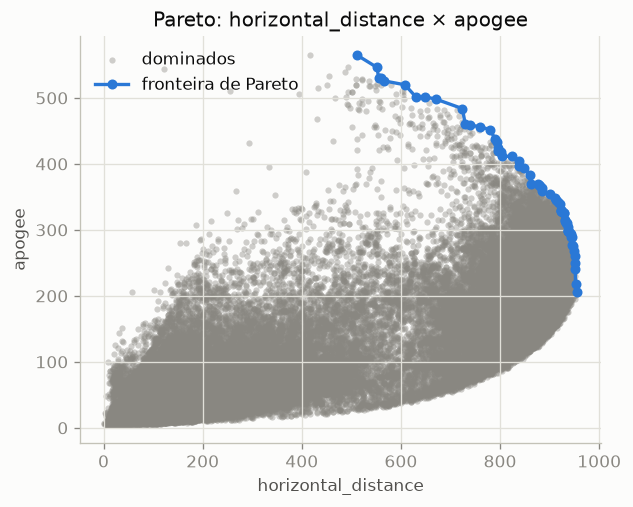
laboratorios/testes-livres/simulacoes/plots/run_2/pareto_apogee_distance.png
