murilo999-666/foguetes-garrafa-pet/laboratorios/testes-livres/simulacoes/plots/run_2/surface_body_diameter_body_length.png

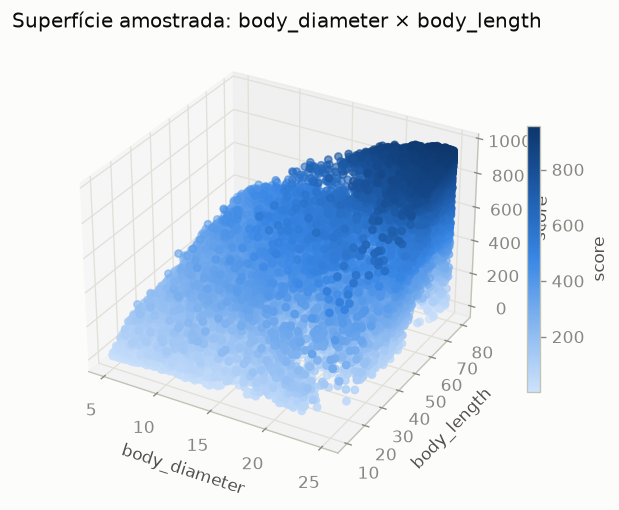
laboratorios/testes-livres/simulacoes/plots/run_2/surface_body_diameter_body_length.png
