murilo999-666/foguetes-garrafa-pet/(commit log)

2026-08-12 OBAFOG: projetos, fabricação e a plataforma de otimização orx
    Consolida o material da equipe num repositório único e organizado.
    Estrutura
    - foguetes/ um diretório por foguete físico (bit01..bit08)
    - laboratorios/ estudos digitais que não viraram foguete
    - orx/ plataforma de otimização (OpenRocket 24.12 headless via JPype)
    - docs/ regulamento, índices, planilhas, referências
    - base-de-lancamento/ CAD da base
    Estado dos projetos vigentes
    - bit07 (2 L): ogiva PLA 24,8 cm + 3 aletas de polietileno 1,0 mm, lastro 180 g.
    1,0 L de vinagre a 55 graus -> 256 m, estabilidade mínima 1,20 cal.
    - bit06 (1,8 L): reprojetado com 99.920 simulações por nota mult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
    [2ogiva.stl, LABORATORIO_resultados.xlsx, LABORATORIO_top20_robustez.csv, _TODOS_OS_TESTES.xlsx, aletas_foguete_MODELO_HUMANO.csv, aletas_foguete_real_otimizado.csv, aletasnovas.stl, api_dump.txt]
2026-08-17 bit06 PET: campanha de 99.920 sims, aerodinamica na nota, e o grid de motores do bit07
    Campanha
    - Coifa de garrafa PET moldada (ogival, 17-18 cm) entra como DADO, nao como
    variavel: otimizar uma coifa que nao existe nao serve para nada.
    - 3 aletas e cant zero fixos (decisao do Murilo: cant que existe no papel e nao
    na peca faz a simulacao contar com um giro que o foguete real nao tem).
    - Nota ganhou 28 pontos de aerodinamica: arrasto (decomposto em atrito/pressao/
    base), amortecimento em arfagem, angulo de ataque e rigidez aeroelastica.
    - Leveza restaurada a 20 pontos (tinha sido cortada a 10 por engano ao abrir
    espaco para os termos novos; era o 3o criterio mais pesado da v1).
    - Anc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
    [bit06pet_aleta_molde.dxf, bit06pet_aletas_3x.dxf, bit06pet_coifa.stl, bit07E_aletas.stl, bit07E_coifa.stl, bit07_B_aleta_molde.dxf, bit07_B_aletas_4x.dxf, bit07_B_coifa.stl]
2026-08-23 Protocolo de testes de campo, e corrige a quem pertence o voo de 275 m
    Entram os documentos que faltavam e saem tres erros de rastreio.
    Protocolo_de_Testes_OBAFOG.pdf (16/jul) nao estava no repositorio. E o
    roteiro do dia de campo: ordem dos testes, ruptura hidrostatica, vedacao,
    gatilho sob pressao, curva pressao x tempo, lancamentos de baixa pressao,
    cinco fichas de registro, kit e seguranca.
    Uma secao dele envelheceu mal. No teste do barbante (2.2) ele diz que o
    foguete cambalhotar carregado 'e esperado (-0,37 cal), nao e defeito, quem
    resolve e o tubo de lancamento'. Em 04/08 o bit04 e o bit05 falharam, e o
    diagnostico do bit07 concluiu o contrario: estabilidade minima de 0,24-0,46
    cal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
2026-08-23 bit08 e bit09 entram no repositorio
    O bit08 era so uma pasta reservada com um LEIA-ME de estrutura sugerida, e o
    bit09 nao existia aqui. Os dois estavam so na pasta de trabalho em
    D:/1-Competicoes/OBAFOG/foguetes.
    bit08 (45 graus, 6 aletas) e bit09 (otimizada, 3 aletas): cada um com o
    MODELO_FINAL.ork, o molde de aleta e o gabarito de alinhamento em PDF, e a
    coifa em STL nas duas formas, inteira e partida em base + ponta. O bit09
    traz ainda tres submodelos com a coifa antiga, para comparacao.
    LEIA-ME de cada pasta escrito, e os dois entram na tabela do indice no lugar
    da linha 'bit08 reservado'.
    Claude-Session: https://claude.ai/code/session_01HsdabuiZCezYbCRtwjB2eL
    [coifa_INTEIRA_parede1.2mm.stl, coifa_PARTIDA_1_base.stl, coifa_PARTIDA_2_ponta.stl]
